SkyHao723/new_gimbal/交接说明.md

# 交接说明 —— 云台电机闭环 FOC 调试（STM32 测试版 → G431 正式版）

> 2026-10-16 G431：已按用户新原理图建立 [G431 Keil5 工程](keil5_g431/README.md)，
> 使用 CAN + AS5600；初步上电诊断已运行，修复 PB8/BOOT0 启动选择。
> SWD 已恢复，最终 CAN 单帧版已下载并校验；170MHz 主循环正常、异常寄存器为0、保持失能。
> 当前 nFAULT=0、编码器未应答。USB-CAN 实际为 candleLight（1D50:606F），走 gs_usb 通道0，
> 不是 COM8；500kbit/s 查询尚无回复。等待接口电压测量，尚未做 G431 旋转测试。
> 用户实测 24V 正常，但 SDA/SCL 约 0.1V，DRV 的 5V 只有约 1.7V，CAN VCC 也取自该 5V。
> 优先检查 Buck 输出电容 CBK（22uF/10V + 22~47uF 储能）、47uH 电感、FB_BK 输出节点及
> VSEL_BK 悬空状态；5V 恢复前不接 CAN 负载、不使能电机。AS5600 若无板载上拉，PB6/PB7
> 还需各加约 4.7kΩ 到 3.3V。

> 2026-10-16：已建立独立的纯 C / SPL / Keil5 工程
> [keil5_foc/gimbal_foc.uvprojx](keil5_foc/gimbal_foc.uvprojx)，保留 PlatformIO 最新参数和功能。
> Keil 全量构建 0 错误/0 警告、离线测试通过。静音稳定基线已提交为 `f888ddb`；
> π 附近到位摆动改善版已提交并推送为 `8b74ca8`；之后的提速候选已烧录、完成短时实测。
> 后续已优化末段收敛并烧录，当前参数、实测和回退见 [到位收敛优化](docs/到位收敛优化-2026-10-16.md)。
> 详细入口：[Keil 工程使用说明](keil5_foc/README.md)。原有目录与以下历史记录保留供参考。

> 用途：把当前工作交给另一个 AI 继续调试
> 生成日期：2026-10-15
> 工作目录：`D:\download\M创动工坊分享资料2.94-未发布`

---

# 一、给接手 AI 的提示词（可直接复制使用）

> ⚠️ **注意**：本文件是"调试过程中的完整记录"。其中第七节列的问题
> 已在 2026-10-15 轮次中修复并实测验证，
> **最新状态请看 `docs/调试成果-2026-10-15.md`**。

```
你接手一个嵌入式电机控制项目，需要继续调试。请先完整读完本文件，再动手。

【项目目标】
最终在 STM32G431 自制板 + DRV8316C 上实现云台电机闭环 FOC。
当前阶段：先用 STM32F103C8T6（蓝板）+ 厂家 SimpleFOC Mini 驱动板做验证，
跑通后再把代码移植到 G431。

【当前进度】
- 已跑通：时钟/I2C编码器/PWM驱动/FOC对齐/闭环位置控制
- 已修复并验证：串口丢包、对齐失败（见 docs/调试成果-2026-10-15.md）
- 待解决：闭环大幅移动时速度环失稳（见该文档第三节）
- 迁移 G431：见"第八节"

【工作方式要求】
1. 这个电机已经因误操作过热过 4 次，安全是第一优先级。
   动手前必读"第六节 安全须知"，里面每条都是踩坑换来的。
2. 主工程在 New_gimbal/foc_official/（PlatformIO + 官方 SimpleFOC 库）。
   构建：cd New_gimbal/foc_official && python -m platformio run -t upload
3. 不要随意改动 platformio.ini 里的 build_flags，那里有几处关键修复
   （串口命名坑、库兼容补丁），注释里已写明原因。
4. New_gimbal/app/ 下是早期用 SPL 手写的固件，已被官方方案取代，
   但其中的诊断思路（外设逐个初始化、串口诊断）仍可复用。
5. 硬件细节、引脚、实测参数都在本文档里，不要凭猜测改接线。
```

---

# 二、硬件清单

| 部件 | 型号/参数 | 备注 |
|---|---|---|
| MCU（当前） | **STM32F103C8T6** 蓝板 | 64KB Flash / 20KB RAM / 8MHz 晶振 |
| MCU（最终目标） | **STM32G431CBT6** LQFP48 | 自制板，尚未开始 |
| 驱动 | 厂家 **SimpleFOC Mini** | 板上芯片是 **DRV8316C**（TI） |
| 电机 | 外转子云台无刷电机 | Ø45×25mm，中空轴 7.5mm |
| 编码器 | **AS5600** 磁编码器 | I2C 地址 0x36，12 位 |
| 磁铁 | 预装径向磁环 Ø10×Ø5.5×2.5mm | **固定在电机轴上，随轴转动** |
| 电源 | 24V，**无电流限制功能，回路无保险丝** | ⚠️ 这是最大安全隐患 |

## 电机关键参数（厂家标称 + 实测）

| 参数 | 值 | 来源 |
|---|---|---|
| 相电阻 | **3.8 Ω**（两相之间） | 实测，两台独立电机一致 |
| 相电感 | 1.3 mH | 厂家 |
| 极对数 | **11** | SimpleFOC 对齐实测估算约 11.28；原厂家资料写 7，按实测闭环结果修正 |
| 额定电压 / 电流 | 24 V / **1.4 A** | 厂家 |
| 堵转电流 | 4.9 A | 厂家 |
| 额定功率 / 扭矩 | 33 W / 0.32 N·m | 厂家 |
| 最大扭矩 | 0.68 N·m | 厂家 |
| 扭矩常数 | 0.23 N·m/A | 厂家 |
| 空载电流 | 0.1 A | 厂家 |
| KV | 54 RPM/V | 厂家 |
| 工作电压范围 | 12–36 V | 厂家 |

**由 3.8Ω 推导的安全电压**（`I = V/3.8`，额定 1.4A → 理论上限 5.3V）：

| 电压 | 电流 | 判定 |
|---|---|---|
| 1.5 V | 0.39 A | 力矩不足，**实测电机不动** |
| **3.0 V** | **0.79 A** | ✅ **实测正常转动** |
| 5.3 V | 1.4 A | 正好额定 |
| 8 V | 2.1 A | ❌ 超额 |

---

# 三、工作目录结构说明

## 3.1 当前主工程（要用的）

```
New_gimbal/
├── foc_official/                    ★★★ 当前主工程（PlatformIO）
│   ├── platformio.ini               工程配置（含关键 build_flags，见注释）
│   ├── patch_simplefoc.py           编译前自动修补 SimpleFOC 与 core 的兼容问题
│   ├── include/MyUart.h             早期手写的寄存器直驱串口（现已被 Serial2 取代）
│   └── src/main.cpp                 ★ 主程序（官方 SimpleFOC 闭环）
├── tools/web_controller/            ★ 浏览器控制器（Web Serial，单文件）
│   ├── index.html
│   └── README.md
└── docs/                            调试文档（见 3.3）
```

## 3.2 早期手写固件（已被取代，可参考思路）

```
New_gimbal/
├── app/                             用 SPL 手写的固件（不依赖 Arduino 框架）
│   ├── mini_test.c                  最早跑通的固件：六步换相 + 电流采样 + 过流保护
│   ├── encoder.c / encoder.h        ★ 健壮版 AS5600 驱动（4 万次读零失败）
│   ├── encoder_test.c               编码器独立测试（磁铁状态/抖动/压力测试）
│   ├── encoder_fast.c               编码器加速版（一次 2 字节读）
│   ├── foc_cl.c                     三相正弦 FOC 闭环（起步死点问题）
│   ├── foc_sixstep_cl.c             六步换相闭环
│   ├── spin2.c                      带保护的旋转测试
│   ├── safe_test.c                  ★ 七层保护架构（安全设计参考）
│   ├── cal_curr.c                   电流采样外部标定
│   ├── peri_test.c                  ★ 外设逐个初始化诊断（定位卡死很好用）
│   ├── uart_dbg.c                   串口收发诊断
│   ├── enc_probe.c                  最小编码器探测
│   ├── Hardware/timer.c             TIM1 三路 PWM 初始化
│   ├── Hardware/delay.c             SysTick 延时
│   ├── SimpleFOC/                   厂家 2019 年移植版库（有 bug，见第五节）
│   ├── MyProject.h                  厂家移植版的头文件
│   └── stm32f10x_conf.h             SPL 配置头
├── build/                           GCC 构建脚本（PowerShell）
│   ├── build_*.ps1                  各固件的构建脚本
│   ├── startup_gcc.s                GCC 启动文件
│   ├── stm32f103c8.ld               链接脚本
│   ├── syscalls.c                   newlib 桩（让 printf 可用）
│   ├── clock.c                      RCC 时钟配置（72MHz）
│   └── diag_common.c                （旧版，已被 clock.c 取代）
├── reference/SimpleFOC_port/        厂家原始 Keil 工程副本（未修改，供对照）
└── library/                         STM32F10x 标准外设库 SPL v3.5.0
```

## 3.3 文档

```
New_gimbal/docs/
├── 官方SimpleFOC方案.md        ★ 当前方案的完整说明（为什么用官方库、两个兼容问题）
├── 官方参考代码索引.md          ★ 官方参考代码位置 + 黄金参数 + SVPWM 等价性推导
├── 安全架构.md                 ★ 七层保护设计（必读）
├── 电流标定结论与更正.md         ★ 电流采样标定的曲折过程与最终结论
├── 闭环调试记录.md              阶段 3 调试记录（7 个重要踩坑经验）
├── 闭环FOC实施规划.md           最初的 6 阶段规划
├── 调试总结与安全指南.md         早期总结
└── 接线检查表.md                接线核对表
```

## 3.4 工作区其他目录（厂家原始资料，只读参考）

| 目录 | 内容 | 是否有用 |
|---|---|---|
| `常用测试源码-配合说明书使用/` | 厂家提供的 3118 个文件 | ★★★ **内含官方 SimpleFOC 完整库** |
| `code/` | Keil 工程（`4_closeloop_M1` 等） | 厂家 2019 移植版，有 bug |
| `说明书/` | 接线图、测试说明 PDF | 查接线用 |
| `代码开源/` | 各种 rar/zip 参考工程 | 其中 `STM32F405_SFOCminiV2-带电流采样.zip` 值得看 |
| `3D模型与尺寸图纸/` | 电机与驱动板 3D | 做结构时用 |
| `相关软件/`、`自制平衡小车-开源地址/`、`test/`（空） | 其他 | 无用 |

### ★★★ 官方库的确切位置（很重要）

```
常用测试源码-配合说明书使用\ESP32_SimpleFOC_BLE\ESP32_SimpleFOC_BLE\
  .pio\libdeps\lolin_d32\Simple FOC\
```

这里面有：
- 官方 SimpleFOC 2.4.0 **完整源码**
- **官方蓝板专用示例**（与我们硬件几乎一致）：
  ```
  examples\hardware_specific_examples\Bluepill_examples\
      magnetic_sensor\bluepill_position_control\     <- AS5600 闭环
      encoder\bluepill_position_control\             <- ABZ 编码器
  examples\hardware_specific_examples\SimpleFOCMini\angle_control\
  ```
- 官方 STM32 驱动：`src\drivers\hardware_specific\stm32\`
- 官方 F1 电流采样：`src\current_sense\hardware_specific\stm32\stm32f1\`
- 内置 AS5600 驱动：`src\sensors\MagneticSensorI2C.cpp` 里的 `AS5600_I2C` 配置

---

# 四、引脚接线（当前 STM32 测试版）

| 功能 | STM32F103 引脚 | 接到 |
|---|---|---|
| PWM1 / PWM2 / PWM3 | **PA8 / PA9 / PA10** | 驱动板 IN1 / IN2 / IN3 |
| EN（使能） | **PB0** | 驱动板 EN（高电平使能） |
| 串口 TX / RX | **PA2 / PA3** | USB-TTL 的 RXD / TXD（**交叉**） |
| 编码器 SCL / SDA | **PB6 / PB7** | AS5600（I2C1） |
| SWD | PA13 / PA14 | ST-Link |
| LED | PC13 | 板载（心跳） |
| GND | GND | **所有设备必须共地** |

**供电**：驱动板进 **24V**；蓝板用 USB 或 5V 脚（**绝不能进 24V**）。

---

# 五、已知的关键坑（都是实测踩出来的）

## 5.1 串口命名坑（导致命令丢一半）

Arduino STM32 core 的定义与直觉不同：

```c
// cores/arduino/Serial.cpp
Uart Serial1(USART1);   // ← Serial1 其实是 USART1 (PA9/PA10)
Uart Serial2(USART2);   // ← Serial2 才是 USART2 (PA2/PA3)
```

- PA9/PA10 已被 PWM 占用，**用 `Serial1` 等于去抢 PWM 引脚** → 收发不可靠
- 正确做法：用 **`Serial2`**，并在 `platformio.ini` 里定义：
  ```
  -D HAVE_HWSERIAL2
  -D PIN_SERIAL2_TX=PA2
  -D PIN_SERIAL2_RX=PA3
  ```
- **不要**定义 `HAVE_HWSERIAL1`，否则 Serial1 会和 PWM 抢引脚

## 5.2 SimpleFOC 2.4.0 与新版 Arduino core 不兼容

```
stm32_mcu.cpp:126: error: cannot convert 'TIM_HandleTypeDef*' to 'TIM_TypeDef*'
    enableTimerClock(handle);
```

**根因**：SimpleFOC 自己的 `enableTimerClock(TIM_HandleTypeDef*)` 被包在
`#if defined(__MBED__)` 里，STM32Duino 下不编译 → 链接到了 Arduino core
的同名函数（签名是 `TIM_TypeDef*`）。

**修复**：`enableTimerClock(handle)` → `enableTimerClock(handle->Instance)`，
已用 `extra_scripts = pre:patch_simplefoc.py` 自动打补丁（重装库也不丢）。

## 5.3 电压太低电机不动

- `voltage_limit = 1.5V` 时**电机完全不动**（力矩不足以克服静摩擦/齿槽力）
- 现象：使能后有保持力、有嗡嗡声、电流约 0.2A，但角度完全不变
- `voltage_limit = 3.0V` 时**正常转动并稳定**
- 3V 下仍有约 0.13 rad 静差（位置环是纯 P 控制，无积分项）

## 5.4 速度读数不可信

转角静止时 `vel` 会乱跳（0.7~2.7 rad/s）。原因：角度只有 ±1 LSB 噪声，
差分测速把噪声放大。**判断电机是否在动要看 `angle`，不要看 `vel`。**

## 5.5 厂家的 SimpleFOC 移植版有 bug（`New_gimbal/app/`）

- **`setPhaseVoltage()` 写 TIM2，但 PWM 在 TIM1** → FOC 算出的占空比
  全写进一个没接输出的定时器，表现为"电机永远不转"
- `SystemInit()` 不配 PLL，实际跑 HSI 8MHz（PWM 变成 2.8kHz）
- I2C 超时后不发 STOP，总线永久卡死

**这就是改用官方库的原因。**

## 5.6 ADC 采样与 PWM 不同步（早期手写固件的问题）

PWM 开着时电流读数在 0.005A 和 0.3A 之间剧烈跳动。
原因：ADC 自由转换（~200kHz）与 25kHz PWM 不同步，平均值要么全落在
"导通期"要么全落在"关断期"。
**官方库的 STM32F1 电流采样实现已处理这个问题。**

## 5.7 其他坑

- **I2C 引脚电平测量前必须先 `PE=0` 关掉外设**，否则读到的是外设拽住的
  状态，会误判成"硬件短路"（我曾因此误判编码器损坏）
- **看门狗在调试阶段有害**：卡死时不断复位，连 ST-Link 都连不上，需断电恢复
- **编译器会把"读标志位"的循环优化成死循环**（`bpl` 跳回自己），
  必须用 `volatile` + 函数封装
- **PowerShell 5.1 中文脚本会乱码**导致语法错误，脚本建议纯 ASCII
- **中文路径会让部分工具误报"文件不存在"**，可建 ASCII 软链接绕过：
  `cmd /c mklink /J D:\dsh_build\xxx "中文路径"`

---

# 六、安全须知（★ 必读，电机已过热 4 次）

## 6.1 当前最大的安全隐患

**电源没有电流限制功能，回路也没有保险丝。** 这是唯一不依赖软件的保护层，
目前完全缺失。

**强烈建议补一个（任选其一）**：
| 方案 | 成本 | 效果 |
|---|---|---|
| 限流电源 | 可能已有 | 首选，电流一到自动降压 |
| **2A 快断保险丝** | 几毛钱 | 未来任何固件出错都能救电机 |
| 10Ω/10W 电阻串联 | 手头可能有 | 临时替代，电流物理限制在 2.4A |

## 6.2 绝对禁止

- ❌ **直流锁死测试**（某两相加固定直流、第三相悬空）—— 无旋转无反电动势、
  无斩波限流，电流完全由 V/R 决定，最容易烧电机
- ❌ 无人监控的长时间通电
- ❌ 电压超过 5V（3.8Ω 下会超过额定 1.4A）
- ❌ 上电前不摸电机温度

## 6.3 每次测试必须

1. 电机固定好，周围无人
2. 手放在电源开关上
3. **用电流表实时监控**（不要只信固件读数）
4. 上电前摸电机温度，热的绝不上电
5. 单次通电时间尽量短

## 6.4 过热事故复盘（为什么电机没坏）

`B2` 直流测试时固件显示 1.62A，但真实电流只有约 0.53A —— 多出的来自
**电流零点漂移**（实测漂 94 counts）。电机实际只承受了额定的 38%，
所以没有匝间短路（两台电机电阻 3.8Ω / 4.4Ω，正常）。

**教训**：标定电流要用**独立可靠的仪表**（电流表串在回路里），
不要用总电源功率计间接推算。

---

# 七、未解决的问题（接手 AI 从这里开始）

> **更新（2026-10-15）**：7.1 和 7.2 已修复并实测验证，
> 详情见 `docs/调试成果-2026-10-15.md`。以下保留记录，供理解来龙去脉。

## 7.1 串口命令可靠性 ✅ 已修复并验证

**现象**：命令大约每两条丢一条。

**根因**：`Serial1` 实际是 USART1（PA9/PA10，已被 PWM 占用），
应该用 `Serial2` 才是 USART2（PA2/PA3）。

**修复**：
- `platformio.ini` 加 `-D HAVE_HWSERIAL2 -D PIN_SERIAL2_TX=PA2 -D PIN_SERIAL2_RX=PA3`
- `main.cpp` 改用核心的 `Serial2`（删掉手写的 `MyUart.h`）

**实测结果**：`20x R → 20/20`，`20x ? → 20/20`，突发 10 条 `→ 10/10`，
参数命令确实生效。**100% 可靠。**

## 7.2 对齐失败导致电机完全不动 ✅ 已修复并验证

**现象**：`dir=UNKNOWN`、`zero_electric_angle=-12345`(NOT_SET)、电机完全不动。

**根因**：对齐电压只有 **1.0V**，推不动转子。
SimpleFOC 的 `alignSensor()` 需要让转子**转一整圈**来测传感器方向
（正转 500 步 + 反转 500 步，比较 `mid_angle`/`end_angle`），
1.0V 正是实测"完全不动"的电压 → 方向检测失败 → FOC 不知道电角度零点
→ 输出电压相位错误 → 电机不动。

**修复**：`ALIGN_VOLTAGE` 从 `1.0f` 提到 `3.0f`。

**实测结果**：`dir=CW`，`zero_electric_angle=2.8256`。

**原则**：**对齐电压必须 >= 能可靠推动转子的电压。**

## 7.3 闭环大幅移动时速度环失稳 ⚠️ 待解决（当前主要问题）

**能工作**：
```
小步移动 0.2 rad:  moved=0.2009  err=-0.0009   (误差 0.09%)
                   moved=0.2010  err=-0.0010
                   moved=0.2101  err=-0.0101
静止保持 3s:       drift = 0.0000 rad          (完全无漂移)
```

**不工作**：累积移动超过约 **0.6 rad** 后失稳
```
step 4: moved=0.9388  err=-0.7388    (期望 0.2)
step 5: moved=-0.7547 err=0.9547
```

**根因**：速度环被编码器噪声污染。AS5600 是 12 位，`vel` 由角度差分得到，
角度仅 ±1 LSB 噪声就被放大成 **2.7 rad/s 的假速度**（实测：静止时
`angle` 完全相同 `4.844`，而 `vel` 在 0.69/0.96/2.73 之间乱跳）。

**建议方向**（每次只改一个参数，用 `test/closedloop.ps1` 复测）：

| 参数 | 当前值 | 建议 |
|---|---|---|
| `LPF_velocity.Tf` | 0.01 | 加大到 0.05~0.1（更强滤波） |
| `PID_velocity.P` | 0.2 | 降到 0.05~0.1 |
| `PID_velocity.I` | 20 | 降到 5~10 |
| `P_angle.P` | 20 | 降到 8~12 |
| `V_LIMIT` | 3.0V | 试 4.0V |

**另一条路**：启用电流采样（CS1/CS2/CS3 → PA0/PA1/PB1），
改用 `TorqueControlType::foc_current`，绕开速度环噪声问题。

## 7.4 电压上限待调优

当前 3.0V 能转但可能不是最优。建议在电流表监控下逐步试 3.0 → 4.0 → 5.0V，
找到既可靠跟踪又不超过额定电流的值。

## 7.5 电流采样未使用

官方库的 STM32F1 电流采样（`stm32f1_mcu.cpp`）没有启用。
驱动板有 CS1/CS2/CS3 输出（接 PA0/PA1/PB1），启用后可做电流环与可靠过流保护。

## 7.6 Web 控制器待联调

`New_gimbal/tools/web_controller/index.html` 已适配固件命令集
（E/D/T/V/L/R/?），解析逻辑已单测通过，串口问题已修复，可实测了。

---

# 八、迁移到 G431 的方案（最终目标）

| 项目 | STM32F103（当前测试版） | STM32G431（最终正式版） |
|---|---|---|
| 时钟 | HSE 8MHz → PLL → 72MHz | HSE 8MHz → PLL → **170MHz** |
| PWM | TIM1 CH1/2/3 → PA8/PA9/PA10 | TIM1 CH1/2/3，**改引脚** |
| 编码器 | I2C1 PB6/PB7（AS5600） | I2C1 或 SPI（建议 MT6701，抗干扰更好） |
| 电流采样 | 未启用 | **ADC1 注入组 + TIM1 触发**（官方库有 G4 支持） |
| 驱动 | 厂家 SimpleFOC Mini | **自制 DRV8316C 板** |
| 库 | 官方 SimpleFOC 2.4.0 | 同一个库，官方有 G4 硬件支持 |

**官方库对 G431 的支持**（已在工作区里）：
```
src\current_sense\hardware_specific\stm32\b_g431\b_g431_hal.cpp
examples\hardware_specific_examples\B_G431B_ESC1\B_G431B_ESC1.ino
```

**移植要点**：
1. PlatformIO 里把 `board = bluepill_f103c8` 换成 G431 对应板子
2. 引脚宏改成 G431 的（`PA8` 等命名通用，但引脚号不同）
3. 串口改用 G431 的（注意 G431 是 `Serial1`=USART1 等，具体看 variant）
4. 时钟配置由 Arduino core 自动处理，一般不用管
5. 电机参数（极对数 11、3.8Ω、额定 1.4A）保持不变；极对数以 SimpleFOC 对齐实测为准
6. **自定义 DRV8316C 板的外围电路设计**见工作区根目录的：
   - `DRV8316C_外围电路设计总结.md`
   - `DRV8316C_三路PWM_电源方案分析.md`
   - `G431_最小系统检查清单.md`

---

# 九、当前状态速查

## 已验证 ✅

| 项目 | 证据 |
|---|---|
| 时钟 72MHz | `SysClk=72000000` |
| I2C 编码器 | AS5600 读数为 `angle=5.0545`；早期版本 4 万次读零失败 |
| PWM + 驱动 | 使能后有明显保持力、嗡嗡声、电流约 0.2A |
| FOC 对齐 | `dir=CW`，`zero_electric_angle=2.8256` |
| **串口可靠性** | **20x R → 20/20，20x ? → 20/20，突发 10 条 → 10/10** |
| **闭环小步移动** | **0.2 rad 步进误差 0.09%~0.5%** |
| **闭环静止保持** | **3 秒漂移 0.0000 rad** |

## 待解决 ⚠️

| 项目 | 状态 |
|---|---|
| 闭环大幅移动失稳 | 累积 > 0.6 rad 后速度环失稳（见 7.3） |
| 电压上限调优 | 3V 能用，未找最优 |
| 电流采样/电流环 | 未启用 |
| Web 控制器联调 | 代码就绪，串口已修好，可实测 |
| G431 移植 | 未开始 |

## 当前固件

`foc_official/src/main.cpp` 是**正式版固件**（串口交互控制，已实测可用）。

启动日志（实测）：
```
SimpleFOC 2.4.0 / STM32F103 + DRV8316C + AS5600
SysClk=72000000
UART: Serial2 = USART2 (PA2/PA3)
[1] sensor AS5600 @0x36  angle=5.6282
[2] driver OK
[3] Vlim=3.00V (~0.79A)  Vellim=20.0
[4] motor.init OK
aligning (initFOC)...
aligned: dir=CW
         zero_electric_angle=2.8256
motor DISABLED - send E to enable
commands: E D T<n> V<n> L<n> R ?
```

闭环实测（`test/closedloop.ps1`）：
```
小步 0.2 rad:  moved=0.2009  err=-0.0009
               moved=0.2010  err=-0.0010
               moved=0.2101  err=-0.0101
静止 3s:       drift = 0.0000 rad
累积 >0.6 rad: 失稳（见 7.3）
```

> ⚠️ **注意**：早期版本曾在 `foc_official/src/main.cpp` 放过"自包含测试固件"
> （参数写死、自动跑一次移动测试）。该版本在 `initFOC()` 后
> **没有调用 `motor.disable()`**，会导致电机持续高频抖动。
> 现在的正式版已有 `motor.disable()`，**不要再退回那个版本**。

---

# 十、常用命令速查

## 构建与烧录

```powershell
cd D:\download\M创动工坊分享资料2.94-未发布\New_gimbal\foc_official
python -m platformio run              # 编译
python -m platformio run -t upload    # 烧录（ST-Link）
```

首次编译会自动下载 STM32 平台 + Arduino 框架 + SimpleFOC 库（约 5 分钟）。

## 固件串口命令（115200 8N1）

| 命令 | 作用 |
|---|---|
| `E` | 使能 |
| `D` | 失能 / 急停 |
| `T<n>` | 目标角度 (rad)，如 `T0.5` |
| `V<n>` | 电压上限 (V)，如 `V3` |
| `L<n>` | 速度上限 (rad/s) |
| `R` | 读编码器 |
| `?` | 状态 |

## 用 ST-Link 复位（固件卡死时）

```powershell
& 'D:\program\STM32CubeCLT_1.21.0\STM32CubeProgrammer\bin\STM32_Programmer_CLI.exe' `
  -c port=SWD mode=hotplug -rst
```

## 隐藏工具

- 工作区里有 `_serial_openloop.ps1`、`_serial_test.ps1`（早期串口测试脚本）
- `D:\dsh_build\` 下有一些调试脚本（软链接与测试脚本，非项目文件）

---

# 十一、一句话总结现状

**硬件与固件主链路已全部打通，且主要问题已修复验证：**
时钟、编码器、PWM、驱动、FOC 对齐、闭环小步定位、串口通信全部正常。

| 状态 | 项目 |
|---|---|
| ✅ | 串口丢包（`Serial1`/`Serial2` 命名坑）—— 已修复，100% 可靠 |
| ✅ | 对齐失败（对齐电压 1.0V 推不动）—— 已修复，`dir=CW` |
| ✅ | 闭环小步移动（0.2 rad 误差 0.09%）+ 静止无漂移 |
| ⚠️ | **闭环大幅移动失稳**（累积 > 0.6 rad）—— 当前主要待解决项 |
| ⚠️ | 速度环参数调优、电流环启用、G431 移植 |

**下一步优先级**：调速度环参数（见 7.3）→ 启用电流采样 → G431 移植。

详细成果见 `docs/调试成果-2026-10-15.md`。
