SkyHao723/new_gimbal/docs/g431-抖动-位置环极限环.md

# 抖动根因之二：位置环增益过高引起 ~57 Hz 极限环（2026-10-28）

## 结论

**"转到位后静止保持时剧烈高频抖动"不是编码器、不是机械、不是某块板的硬件问题，而是
`MOTOR_ANGLE_P = 40` 在 398 Hz 控制频率下裕度不足引出的极限环。把位置环增益降到 25 后，
三块板都能复现的抖动彻底消失，位置精度与匀速抖动基本不变。**

- 同一套固件/参数下，三块板都会在"走一段 → 停住"之后振荡（`angle_std` 29~48 mrad、
  峰峰 90~113 mrad），只是 2 号电机最容易激发，所以之前看起来像"只有 2 号有问题"。
- 抖动只在**保持阶段**出现，转动过程正常；这与"编码器坏了"的表现（转动中也乱跳）不同。
- 已被排除：AS5600 低功耗（CONF=0，`updates/s` 400+）、编码器静态噪声（失能时 3 秒内
  `angle` 跨度 0.0015 rad）、电流读数（uq 与实测母线电流已对齐）、三相/功率级（DC 锁相
  六步 ±0.08 A 对称）。

## 量化证据

复现序列（`D:\dsh_build\osc_probe.py`，经 CAN）：

```
D → V2.5 → E → T(目标-2rad) → 等 2.5s → T(目标) → 1.2s 后采样 R 1.5s
```

| 板 | `MOTOR_ANGLE_P` | hold -1.0 rad | hold +2.0 rad | hold +π |
|----|---|---|---|---|
| node1 | 40 | 35.0 mrad | 37.7 mrad | 35.7 mrad |
| node2 | **25** | **2.01 mrad** | **1.14 mrad** | **0.97 mrad** |
| node3 | 40 | 38.8 mrad | 35.7 mrad | 39.9 mrad |

（表中为 `angle_std`；node2 单独改成 25 后同序列完全安静，2.5V 与 8V 上限都是 1~2 mrad。）

板载黑匣子抓到的原始波形（`X` 命令，1200 拍 @398 Hz）：

```
angle 在 -1.058 ~ -0.948 rad 之间摆动（峰峰 110 mrad ≈ 72 counts）
每 4~6 拍一个来回 → 观测周期 17.6 ms（≈57 Hz，接近采样率的 1/7）
uq 有 32% 的采样顶在 ±2.5 V（vlim 饱和）→ 典型极限环
把 vlim 降到 1.2 V（uq 无法饱和）→ 抖动消失（pp 4.6 mrad）
```

## 为什么是增益问题

- 位置环是"位置误差 → 速度指令"的 P 环：`velocity_sp = Ap·(target-angle)`，
  Ap=40 相当于 40 rad/s 的刚度，而控制频率只有 398 Hz（软件 I2C 读 AS5600 占掉 2.25 ms/拍）。
- 速度反馈经过 `Tf = 0.02 s` 一阶低通，在 57 Hz 处相位滞后很大、幅值被压到 ~10%，
  等于**高频段几乎没有阻尼**；再加上位置环 40 的高增益和一拍采样延迟，闭环在 50~60 Hz
  附近相角越过 180°，于是自激。
- 电机静摩擦/齿槽越大越容易激发 → 2 号电机最先暴露。
- 增益降到 25 后裕度重新变正；实测 1 rad / 2 rad 阶跃稳态误差 0.006~0.017°（与 40 时的
  0.0002~0.002 rad 同量级），1.5 / 9 rad/s 匀速抖动 7.8 / 11.2 mrad（比 40 时略好）。

## 想更硬的位置环怎么办

不要直接加 `MOTOR_ANGLE_P`。先把控制频率提上去：

1. `New_gimbal/keil5_g431/BSP/as5600.c` 的 `ENCODER_I2C_HALF_US`（当前 25 µs ≈ 20 kHz SCL）
   降到 5 µs 可把循环提到 ~1.9 kHz（2026-10-27 实测 `sensor_errors` 仍为 0）；
2. 循环快了以后再逐步加 Ap，同时观察本文件里的复现序列。

## 复现与排查步骤

1. 固件保持 `G431_*_TEST` 全 0（交付态），板子跑正常闭环固件。
2. 用 `D:\dsh_build\osc_probe.py <vlim> <hold...>` 直接对比三块板；
   输出 `angle_std > 20 mrad` 即说明还在振荡。
3. 需要原始波形时：`{"node":N,"cmd":"X"}`（网页上的「抓抖动波形 (X)」按钮等价），
   3 秒后 `nm` 取 `bench_trace` / `bench_trace_meta` 地址，
   `STM32_Programmer_CLI -r32 <addr> <bytes>` dump，再用 `D:\dsh_build\trace_osc.py` 统计。

## 改动清单（本次）

- `New_gimbal/keil5_g431/User/motor_config.h`：`MOTOR_ANGLE_P 40.0f → 25.0f`。
- 黑匣子（此前未入库，随本次一起提交）：`can_commands.c` 白名单加 `X`、
  `main.c` 的 `trace_armed` 记录与 `X` 命令、`bench_current.c/h` 的 `bench_trace[1200*3]`
  与 `bench_trace_run()`、`tools/g431_can_bridge.py` 的 `SINGLE_BYTE += "X"`、
  `tools/web_controller/index.html` 的「抓抖动波形 (X)」按钮。

## 三块板复测（2026-10-28，全部烧入 `MOTOR_ANGLE_P=25`）

同一复现序列，`angle_std`：

| 板 | hold -1.0 | hold +2.0 | hold +π | 阶跃误差 |
|----|---|---|---|---|
| node1 | 0.73 mrad | 1.03 mrad | 6.65 mrad | 0.006~0.109° |
| node2 | 1.87 mrad | 0.95 mrad | 1.16 mrad | 0.006~0.017° |
| node3 | 2.84 mrad | 1.03 mrad | 1.34 mrad | 0.011~0.080° |

改前 node1 / node3 同序列分别是 35~38 mrad 与 36~40 mrad。三块板同总线同时动作的互扰复测
（`multi_test.py`）最大误差 0.0001 rad，只命令 node2 时 node1/node3 漂移 0.00000 rad。

## 未完成

- 本极限环是"采样率 + 增益"问题。若后续把循环提到 1.9 kHz（软件 I2C 半周期 25 µs → 5 µs），
  需要重新扫一遍 `MOTOR_ANGLE_P` / `MOTOR_VELOCITY_*` 的最优值，可以试更高的位置刚度。
- node1 在 +π 处仍有 6.65 mrad（远小于振荡时的 35 mrad，可接受）；若要求更高可再单独看该角度。
