SkyHao723/new_gimbal/docs/motor-limits-2026-10-27.md

# 电机参数与固件限幅（2026-10-27）

依据用户提供的电机参数表：额定电压 24V、额定电流 1.4A、堵转电流 4.9A、额定转速 1000rpm、额定功率 33W、相电阻 5.4Ω、绕组电阻 3.6Ω、扭矩常数 0.23Nm/A。电阻字段彼此不一致，因此只作范围估算，不当作实测电流。

## 本次调整

仅 G431 源码的默认电压指令上限从 3V 调到 4V；软件绝对上限保留 5V。F103 配置和用户已有控制器改动保持不变。按电阻字段估算，4V 静态电流约为 0.74A（按 5.4Ω）至 1.11A（按 3.6Ω），约为额定电流的 53%～79%；对应扭矩粗估约 0.17～0.26Nm。实际相电流受电机接法、SVPWM 电压定义、PWM 纹波、运动反电势和绕组温升影响，必须用实测确认。

没有提高 5V 绝对上限、加速度或启动动作。软件速度参数 MOTOR_VELOCITY_LIMIT=20rad/s 约 191rpm，但轨迹 MOTOR_TARGET_SLEW=6rad/s（约 57rpm）才是当前实际命令速度上限；相对电机 1000rpm 额定速度，这已经很低。单独抬高速度上限不会解除 6rad/s 轨迹限制。

## 保护能力边界

现有 FOC 软件是电压模式：没有在控制算法中实现运行时相电流闭环/限幅，也没有电机绕组温度传感器。因此 4V 是温和的电压起点，不是“保证不会烧”的热保护。额定电流通常按厂家冷却和工作条件给定；长时间堵转或静态大力保持仍需测温、监控实际相电流并限制连续负载。

## 当前版 G431 原理图复核（2026-10-27）

用户提供的 2026-10-20 当前版原理图已归档到 [`hardware/g431-current-2026-10-20`](hardware/g431-current-2026-10-20/)。按图中硬件引脚配置型 DRV8316：MODE 通过 47kΩ 接 VDD/AVDD，INLA/B/C 接 VDD，选择 3x PWM；VREF/ILIM 接 VDD/AVDD；GAIN 接 PGND，SOA/SOB/SOC 分别接 PA0/PA1/PA2。按 TI DRV8316 数据手册，GAIN 接地对应 0.15V/A 电流检测增益，三路模拟电流检测输出可供 MCU 使用。

因此新板具备实现软件电流监测/限流的硬件信号路径，但当前 G431 FOC 工程没有 ADC 初始化或采样代码，仍是电压模式。SOx 检测的是各相低侧 FET 电流，固件需按 PWM 时序采样并先校准零电流偏置，不能把三个任意时刻的 ADC 电压直接当作绕组电流。

OCP/SR 接 PGND。TI 数据手册对 OCP 引脚接 AGND 的硬件配置给出典型 16A（最小 10A、最大 21.5A）过流阈值；该阈值高于电机 4.9A 堵转电流，不能作为电机绕组保护。DRV 内部过温关断保护的是驱动芯片本身，也不保证绕组安全。数据手册：[DRV8316](https://www.ti.com/lit/ds/symlink/drv8316.pdf)。

当前版图中 DRVOFF 固定接 PGND，MCU PB1 标注未连接；实际硬件停机应使用 PB0/nSLEEP 拉低并清 TIM1.MOE。普通 FOC 工程的 `board_driver_set(0)` 目前清 MOE 并操作未连接的 PB1，但没有拉低 PB0/nSLEEP，因此适配停机路径并复核之后才可刷入当前板。当前板仍运行独立诊断固件，G431 FOC 的 4V 参数仅在源码中，尚未刷入。

在添加、校准并验证同步电流采样及软件过流停机前，保持 4V 默认电压和 5V 软件绝对上限，不把 OCP 或电压指令当成电机热保护。
