SkyHao723/new_gimbal/docs/网页位置运动优化-2026-10-16.md

# 网页角度运动平滑性优化（2026-10-16）

> 本文记录第一轮候选及当时测试。之后用户反馈 π 附近仍有约 3° 摆动，
> 已复现并继续调整反馈增益/滤波；当前参数和烧录状态见 [到位振荡调参](到位振荡调参-2026-10-16.md)。

用户澄清：上电自检只有很轻微的顿挫，主要问题是网页发送角度后运动抖动。
静音、静止保持稳定的源码已经提交为 `f888ddb`。本次修改当时在其后单独保留，
之后与到位振荡调参一起经用户确认改善、授权提交和推送。

## 修改

Keil 工程的普通 `T<n>` 位置控制采用梯形速度规划：规划速度上限 4rad/s，且服从 L；
规划加速度上限 4rad/s²。原来的目标匀速斜坡在开始/到位时改变目标速度，新规划增加
加速和减速段。位置环叠加规划速度前馈，减少跟随移动目标所需的位置滞后。
这是针对起停和目标跟随的改进，不能据此认定其他速度下的全部抖动来源。

运动中收到新 T，保留规划位置/速度后重新计算制动和后续运动；目标位于制动距离内时，
规划允许先制动越过目标，再反向返回。L 降低时规划速度逐步降低，速度环的 L 硬限幅仍
立即生效。E 从当前位置重新开始；D 清空规划；重复 E 不重置已有运动。

上述约束针对参考轨迹，不代表实测机械速度/加速度必定满足这些界限。
梯形规划的位置和速度连续，加速度分段变化，未实现限制 jerk 的 S 曲线。
速度 PI、位置 P、速度滤波、PWM、固定校准和上电单圈流程沿用基线。
网页仍发送同样的 T 指令，本次无需更新网页。

实现入口：`../keil5_foc/Control/trajectory.c`、`../keil5_foc/Control/motor.c`；
参数入口：`../keil5_foc/User/motor_config.h`。

## 实机记录

使用 COM8 / 115200、3V 电压上限，每次使能约 2.3 秒：从当前位置向正方向走一个小步，
1.15 秒后返回起点，再等 1.15 秒。查询约 44 次/秒，每次均以 D 结束并确认 EN=OFF。
基线使用优化前板上原有固件；候选使用 ST-Link 下载并由 STM32CubeProgrammer 校验通过。
每次复位后立即 D 中止自动单圈，本轮未重新测试完整上电单圈。

| 版本 / 步长 | 正向采样超调 | 正向末段摆幅 | 返回末段摆幅 | 正向累计路径 |
|---|---:|---:|---:|---:|
| 原基线 / 0.2rad（11.46°） | 2.78° | 5.63° | 0.00° | 36.91° |
| 初版规划，8rad/s² / 0.2rad | 1.90° | 0.09° | 0.00° | 15.76° |
| 当前规划，4rad/s² / 0.2rad | 未采到越过目标 | 0.09° | 0.18° | 11.94° |
| 当前规划，4rad/s² / 0.5rad（28.65°） | 未采到越过目标 | 0.36° | 0.26° | 28.83° |

末段摆幅是每个动作 0.8～1.15 秒的实测角度最大值减最小值；可能包含尚在收敛的运动。
累计路径是相邻采样的角度变化绝对值之和，基线明显多走的路程说明存在反复摆动。
当前版本 0.2rad 正向末点误差约 -0.034°；0.5rad 正向/返回末点误差约 -0.080° / +0.178°。

这是各一次短时往返对比，起始机械位置随复位后的短暂自检移动而不同，未做同位置重复
统计；采样也可能遗漏更短的振动。AS5600 单个计数约 0.088°，接近计数级的摆幅不宜过度
解读。本轮未测声音，也未覆盖全部速度、角度和负载，最终手感与噪声仍需用户体验确认。

原始采样与当时的测试脚本存于 [measurements/2026-10-16-motion](measurements/2026-10-16-motion)。
脚本默认会使能并运行小步往返，`--flash` 可指定待下载的 HEX；依赖本机 COM8、pyserial
和上述 STM32CubeProgrammer 安装路径。

## 构建与回退

Keil ARMCC 5.06 全量构建：0 错误、0 警告。

```text
Code=14096 RO-data=556 RW-data=68 ZI-data=3892
Flash=14720 bytes; RAM=3960 bytes（含栈和堆）
HEX SHA256=8656014B5AC5640361360A45947002113FF4F35F62D08DD52F79A47132A96959
```

主机测试通过：147 组轨迹终点/速度/加速度用例、变步长跨段积分、运动中反向重规划、
降速、规划完成保持、静止 PI 回归、速度前馈接入、D/E 重置，以及既有 PWM/编码器/
PI/故障/上电单圈状态机测试。离线测试不替代实机反馈。

当前烧录文件已另存 `D:\dsh_build\releases\gimbal-smooth-20261016\gimbal_foc.hex`。
稳定基线仍为 `f888ddb`，其 HEX / AXF 保存在 `D:\dsh_build\releases\gimbal-f888ddb`，
基线 HEX 哈希复核不变，见 [稳定基线](稳定基线-2026-10-16.md)。
需要回退时可用 ST-Link 下载该目录的基线 HEX；源码可在独立检出 `f888ddb` 后构建，
无需丢弃当前未提交的优化。
