SkyHao723/new_gimbal/docs/稳定基线-2026-10-16.md

# Keil 固件稳定基线（2026-10-16）

用户实机反馈：当前固件已无可感知噪音，停在指定位置时不抖动；运动时仍有顿挫感。
本记录将该反馈与当前源码保存为基线。声音与静止表现来自用户观察，未做声级仪测量。

工程：`keil5_foc/gimbal_foc.uvprojx`，STM32F103C8T6，ARMCC 5.06，纯 C99 / SPL。
参数：11 极对、方向 +1、固定电角度零点 0.92rad、电压上限 3V、速度 PI 0.2/5、
速度低通 0.05s、位置 P=20、位置目标匀速斜坡 4rad/s；上电开环转一圈后失能。

构建结果：0 错误、0 警告。当前 HEX 的 SHA256：

```text
72344E5D26A3060A4DC210241FE11B0350F7ADE612BFAD654F18D3542D550827
```

源码、标准库、Keil 工程配置和测试纳入版本管理，Objects/Listings 等生成文件继续忽略。
后续运动平滑性修改须与该基线分开，保留可回退版本；静止 PI/零点参数不应无依据改动。
