SkyHao723/new_gimbal/docs/闭环FOC实施规划.md

# 闭环 FOC 实施规划

> 目标：在 **测试版**（STM32F103C8T6 + SimpleFOC Mini/DRV8316C + AS5600）上打通闭环
> 原则：**安全性优先**，每一步独立可验证，任何一步失败都能安全回退
> 基线：固件 `mini_test.c`（六步换相）已实测通过，作为**永远可回退的安全版本**

---

## 一、现状与阻塞点

### 已完成（有实测依据）

| 能力 | 验证方式 |
|---|---|
| PWM TIM1/PA8-9-10，25kHz 中心对齐 | 寄存器 `BDTR=0x8000`、`CCER=0x111`、`ARR=1439` + 万用表实测 |
| 六步换相旋转 | 空载电流 < 0.1 A（标称 0.1 A） |
| 电流采样 + 零点标定 | 漂移 ±0.005 A；1V→0.142A / 2V→0.317A，反推电阻 6.5Ω |
| 过流硬切断 | 自检通过（阈值降到 0.05A 未误触发） |
| 72MHz 时钟 | `SystemCoreClock=72000000` |

### 唯一阻塞点：编码器在控制循环中的可靠性

**现象**
- 调试固件里，`Motor_init()` 帧内读 `getAngle()` 正常
- 但在**控制主循环**中长期运行后，读数失败 → `I2C_getRawCount()` 返回 0 → `shaftAngle` 变 **NaN**
- 慢速调 `angle=nan` 反复出现

**根因分析（三个叠加因素）**

1. **I2C 驱动本身脆弱** — 原参考工程用「POS 位技巧 + 直接寄存器操作」，且所有超时路径 `return 0` **不发 STOP**，一次失败就把 SCL 拉死（已修，但未在闭环中验证）
2. **400kHz 在排线上太快** — 信号完整性差，读十次错两三次
3. **无数据有效性检查** — 脏数据（0 / NaN）直接被 FOC 拿去算换相角

**危害等级：高**
编码器脏数据 → 换相角错误 → 电机失步 → 等效堵转 → 大电流（与 145W 事故同一机制）

### 设计原则

> **编码器不可信，就绝不能开闭环。**
> 因为开环至少是"我知道它在转"，闭环脏数据是"它在乱转还可能烧电机"。

---

## 二、阶段划分

每个阶段都有：**目标 / 任务 / 验收标准 / 停止条件**
**未通过验收，不进入下一阶段。**

---

### 阶段 0 — 基线与安全网（0.5 天）

**目标**：确保任何时候都能安全回退到已验证的开环版本

**任务**
- [x] `mini_test.c` 已推送到仓库（可回退基线）
- [ ] 备份当前可工作固件 `mini.hex` 到 `firmware/` 目录
- [ ] 确认恢复流程：一条命令烧回开环版
- [ ] 建立测试记录表（电压 / 电流 / 现象）

**验收**
- 能从仓库产物烧回开环版并成功转起来

**产出的安全网**
```
任何时候出问题 → 烧 mini.hex → 回到已知可用状态
```

---

### 阶段 1 — 编码器可靠性攻坚（★ 最高优先级，1~2 天）

**目标**：AS5600 在**控制循环频率下**（≥ 1kHz 读取）长期稳定，错误率 < 0.1%

**为什么单独作为一个阶段**
这是唯一的阻塞点，且解决它需要独立的测试装置。不掺任何电机控制代码，
纯粹验证"读角度"这一件事。

**任务**

1. **重写 I2C 读角度驱动**（不复用原参考代码）
   - 速率降到 **100 kHz**
   - 标准两步读（不用 POS 位技巧，简单优先）
   - 每个超时点：发 STOP + 清 POS + 恢复 ACK
   - 加**总线恢复**：卡死时用 SCL 脉冲解救从机
   - 读失败时返回一个**明确无效标志**，而不是 0

2. **数据有效性校验**
   - 连续两次读，差值 < 阈值才接受
   - 与上一次比，跳变 > 某阈值 → 判为野值丢弃
   - 累计失败计数器（可读）

3. **独立测试装置**（新固件 `encoder_test.c`，不接电机）
   - `R` 连续读取 N 次，打印失败次数与角度抖动
   - 静态：读数应稳定（抖 < 2 LSB）
   - 手动转轴：角度应单调变化
   - **持续 10 分钟压力测试**

**验收标准**

| 指标 | 要求 |
|---|---|
| 静态角度抖动 | < 2 LSB (4096) |
| 手动连续转动 | 角度单调、无跳变 |
| 10000 次读取失败率 | **< 0.1%** |
| 失败后能否自愈 | 下一次读必须成功（不能卡死） |
| 10 分钟长跑 | 无累积性失败 |

**停止条件**（任一出现则暂停，换方案）

- 错误率 > 1% 且降速/加滤波无效
- 总线反复卡死，恢复机制不能自愈

**备选方案（按优先级）**

1. 降到 100 kHz + 缩短排线 + 检查上拉（**首选，最可能直接解决**）
2. 增加"读两次取一致"的双读冗余（软件容错）
3. 改用 AS5600 的 **PWM 输出**（单线，抗干扰远好于 I2C，引脚 PA0/PA1/PB1 已有）
4. 换成 SPI 编码器（MT6701，厂家也有资料）

> ⚠️ 注意：仓库 `reference/` 里有厂家给的其他方案（ESP32 + MT6701 等），
> 如果 AS5600 实在不稳，换编码器比死磕 I2C 更划算。

**产出**：`app/encoder.c/.h` —— 一个经过验证的、可信的角度读取模块

---

#### 阶段 1 实测结果（✅ 已通过）

**测试时间**：2026-10-15　**固件**：`app/encoder_test.c`（不输出 PWM，EN 保持失能）

| 测试项 | 结果 | 判定 |
|---|---|---|
| SCL/SDA 空闲电平 | 均为 HIGH | ✅ 上拉有效 |
| 静止抖动（1000 次） | 跨度 **1 LSB** | ✅ 要求 < 5 LSB |
| **400 kHz 抖动（500 次）** | 0 / 1000 失败 | ✅ 400kHz 也能用 |
| **100 kHz 抖动（1000 次）** | 0 / 2000 失败 | ✅ |
| **压力测试 20000 次** | **0 / 40000 失败，错误率 0.0000%** | ✅ **要求 < 0.1%** |
| abort（超时清理） | **0 次** | ✅ 从未超时 |
| recover（总线恢复） | **0 次** | ✅ 从未卡死 |

**重大发现：原判断错误修正**

我原先怀疑"400 kHz 在排线上信号完整性差"，**这是错的**。
实测 **400 kHz 同样 0 失败**。

真正的根因是：**原驱动在所有超时路径直接 `return 0`，不发 STOP → 一次失败就把总线永久拉死**。
一旦卡死，之后每次读都失败，`angle` 就恒为 0 / NaN。

**修复三要素**（`app/encoder.c`）
1. 每个等待点都有有限超时，超时后**必发 STOP**释放总线
2. 失败返回**明确错误码**，绝不返回 0 冒充有效角度
3. 数据校验：双读一致性 + 跳变丢弃 + 统计（abort/recover/outlier）

**仍有待关注的问题：磁场偏弱**

```
STATUS=0x33  AGC=128  MAGNITUDE=909
  MD=1（检测到磁铁）  ML=1（磁场太弱❗）  MH=0
```

`ML=1` 且 `AGC=128`（正常应接近 0）说明**磁铁与芯片间距偏远**。
虽然角度读数稳定，但弱磁场可能导致**角度非线性/精度下降**，
影响 FOC 换相质量。**建议在进入阶段 3 对齐前先处理**：

- 把磁铁往芯片方向靠近（目标 AGC 降到 0~50，ML 清零）
- 或确认厂家预装磁铁是否松动/错位

---

### 阶段 2 — 引入 FOC 库并安全共存（1 天）

**目标**：让 SimpleFOC 库可以运行，但**先不闭环**，确认不会像之前那样卡死

**背景**：之前诊断固件反复卡死（PC 停在 `b.n` 自循环），确认是
SimpleFOC 库与自写代码混用时的状态干扰。必须重新设计集成方式。

**任务**
- [ ] 以 `reference/SimpleFOC_port` 为基础，**把已修复的 4 个 bug 固化进去**
  - `setPhaseVoltage` 写 **TIM1**（已修）
  - `SystemInit` → 显式配置 72MHz（已修）
  - I2C 超时清理（阶段 1 会重写，这里对接）
  - 电流零点在 EN 之后标定
- [ ] **加看门狗**（IWDG）：防止卡死后电机持续通电
- [ ] 库只跑"空转"测试：`loopFOC()` 空跑，目标恒为 0，观察是否稳定
- [ ] 确认 `shaft_angle`、`shaft_velocity` 不再出现 NaN

**验收**
- `loopFOC()` 连续运行 **30 分钟**不卡死
- 目标恒 0 时电机不转、电流 < 0.2 A
- 编码器读数在库环境下仍然可靠（复用阶段 1 的统计）

**停止条件**：仍出现卡死 → 说明库集成有问题，需要进一步隔离（例如把 FOC 计算放到定时器中断里，与主循环解耦）

**产出**：`app/foc_closedloop.c` —— 可稳定运行的空转闭环框架

---

#### 阶段 2 实施记录（进行中）

**集成方式（关键设计）**

参考工程的 `MyProject.h` 会把 `iic.h` 一起包含进来，导致**库直接操作 I2C** ——
而那个 I2C 驱动正是阶段 1 判定为"会卡死总线"的版本。

所以本工程采用**隔离式集成**：

| 文件 | 作用 |
|---|---|
| `app/MyProject.h` | **精简版**：去掉 iic.h/spi2.h，只保留库需要的类型、宏、全局变量声明 |
| `app/encoder.c/.h` | 阶段 1 验证过的健壮 I2C 驱动 |
| `app/foc_idle_test.c` | 把库的 `getAngle()`/`getVelocity()` 桥接到 `encoder.c` |
| `app/SimpleFOC/*` | 库源码（原样复制，仅 include 指向精简版 MyProject.h） |
| `app/Hardware/timer.c` `delay.c` | 原样复制 |

**这样库永远不碰 I2C，只用我们验证过的接口。**

**首次启动结果（✅ 不卡死）**

```
[1 s] angle=0.4602 vel=0.0000 Hz=1000 NaN=0 ok=4002 fail=0
[2 s] angle=0.4602 vel=0.0000 Hz=1000 NaN=0 ok=8002 fail=0

EN=OFF          ← 电机失能
CCR 0/0/0       ← PWM 全零
voltage.q=0.0000 voltage.d=0.0000
NaN count=0
encoder fail=0  abort=0  recover=0
loop: 1000 Hz
>>> HEALTHY
```

**发现并规避的一个严重隐患**

`FOCMotor.c` 里 `voltage` 是**全局未初始化变量**：

```c
DQVoltage_s voltage;   /* 无初值！ */
```

而 `loopFOC()` 会**无条件**执行：

```c
setPhaseVoltage(voltage.q, voltage.d, electrical_angle);
```

⇒ 如果不在使能前显式清零，**上电第一次 `loopFOC()` 就会把随机值写进 PWM**！
本固件已在 `motor_init` 后显式 `voltage.q = voltage.d = 0`。
**这一点在阶段 3/4 使能电机前必须再次确认。**

**实测到的两个待改进点（进入阶段 3 前处理）**

1. **主循环只有 1 kHz**，瓶颈是编码器 I2C 读取
   - 当前 `as5600_read_raw()` 分两次独立读（各含地址/寄存器/重复起始/停止）
   - 改进：合并成**一次 2 字节读**，预计可翻倍到 ~2 kHz
   - ⚠️ 注意：这属于**修改阶段 1 已验证的驱动**，必须重新跑
     `T20000` 压测确认错误率仍为 0

2. **`getVelocity()` 恒返回 0**（空转时无害，但闭环必需）
   - 根因：用了未递增的毫秒计数器，`dt ≈ 0` 被下限截断
   - 修复：改用 SysTick 自由计数时基
     `dt = (0xFFFFFF - SysTick->VAL) 差值 / 9e6`（9MHz）
   - 必须**先验证速度读数正确**（手动转轴看 vel 变化），再进阶段 4

---

### 阶段 3 — 对齐（★ 最危险的一步，1 天）

**目标**：让 `alignSensor()` 成功，得到 `sensor_direction` 与 `zero_electric_angle`

**为什么危险**
对齐会强制电机做开环旋转，且**在闭环代码路径里**。参数不对会让电流失控。

**任务**

1. **对齐参数收紧**
   - 对齐电压：从 **1.5 V** 起步（对应约 0.23 A），不够再逐步加
   - 必须 < `voltage_limit`
   - 限制对齐过程的总转角和持续时间

2. **每个对齐步内插入过流检查**
   ```
   for 每一步:
       setPhaseVoltage(align_v, angle)
       读电流 → 超限立即 EN 拉低 + 中止
       延时
   ```
   > 原库的 `alignSensor()` 内部是 `delay_ms(2)`，**没有电流检查**，
   > 必须在循环体里插入。

3. **分步观察**
   - 先只跑"前 500 步正转"，打印 mid/end 角度，确认能测到运动
   - 再跑完整对齐

4. **结果校验**
   - `sensor_direction` 必须是 ±1，不能是 0
   - `zero_electric_angle` 应落在 [0, 2π]
   - `PP check: OK!` 或打印出建议极对数

**验收**
- `sensor_direction = CW 或 CCW`（非 0）
- `zero_electric_angle` 是有限值
- 极对数校验通过（或按提示改正后通过）
- **全程最大电流 < 1.5 A**

**停止条件**
- 反复 `Failed to notice movement` → 编码器又不可信了，**回到阶段 1**
- 对齐时电流异常 → 立即停，检查对齐电压与电机接线

**产出**：对齐参数字典（记录成功的电压、耗时、方向、零点）

---

### 阶段 4 — 闭环三模式逐步验证（1~2 天）

**目标**：力矩 → 速度 → 位置，逐个跑通

#### 4.1 力矩模式（最先做，最好观察）

**为什么先做**：给固定电角度 → 转子锁在固定位置 → **不动 = 不会失步 = 最安全**

- 任务：给固定 `Uq`（从 1V 起）和固定电角度，观察转子是否锁住、电流是否与 `V/6.5` 吻合
- 验收：转子锁定不抖；电流符合 `I ≈ V/6.5`；松开后能保持位置
- 安全：`Uq` ≤ 2V，超流立即断

#### 4.2 速度模式

- 任务：从**很小的目标**开始（`T1` = 1 rad/s），PID 先给保守值
- 观察：响应方向对不对、有没有振荡、`shaft_velocity` 是否跟随
- 验收：能稳定跟随给定；无发散；**电流 < 1.4 A 额定**
- 安全：`velocity_limit` 先设小（如 10 rad/s）；目标值逐步加

#### 4.3 位置模式（最后做）

- 任务：给定阶跃目标，观察是否到位、有无过冲/振荡
- 验收：稳态误差可接受；无持续振荡；阶跃响应可重复
- 安全：阶跃幅度先小（±0.5 rad）

**PID 调参原则（安全第一）**
```
先 P 小、I=0、D=0  → 慢慢加 P 到刚好有响应
再加 I 消除稳态误差（注意积分饱和 → 库里有 antiwindup）
最后加 D 抑制过冲
每个参数只改一个，且每次改完先看电流
```

**产出**：三套可用的 PID 参数 + 每种模式的测试记录

---

### 阶段 5 — 电流保护接入闭环 + 精度复核（1 天）

**目标**：把已在六步换相中验证过的电流保护，**无缝搬进闭环**

**任务**
- [ ] 闭环循环内每周期检查电流，超阈值立即 EN 拉低
- [ ] 复核电流采样精度：**在 PWM 中点采样**（而不是我目前用的 DC 平均）
  - 闭环下 MOSFET 开关，CSA 输出会随 PWM 变化，中点采样才准
  - 用外部电流表对比标定 `A_per_count`
- [ ] 增加"堵转检测"：速度接近 0 但电流很大 → 判定堵转 → 停
- [ ] 增加"失步检测"：`shaft_velocity` 与目标差距过大且电流高 → 停

**验收**
- 人为堵转电机，保护在 100 ms 内切断
- 高速运行时电流读数与实际吻合（误差 < 20%）

---

### 阶段 6 — 稳定固化与文档（0.5 天）

**目标**：把可用状态固化并记录

**任务**
- [ ] 整理最终固件，所有安全参数集中到文件头
- [ ] 记录：可用的对齐电压、PID 参数、各模式安全上限
- [ ] 更新 `docs/` 与 README 的「已验证 / 待办」表
- [ ] 提交并推送
- [ ] 写「G431 移植对照表」：引脚差异、时钟差异、需要改的地方

**验收**
- 新烧录的板子按文档操作可复现闭环

---

## 三、安全设计总表

| 层 | 措施 | 触发条件 | 动作 |
|---|---|---|---|
| 1 | **电源限流** | 实验室电源设 1.5 A | 硬件兜底 |
| 2 | **软件过流** | 电流 > 1.5 A | 立即 EN 拉低 |
| 3 | **电压上限** | `voltage_limit` ≤ 5 V | 限制最大电流 |
| 4 | **速度上限** | `velocity_limit` 从 10 rad/s 起 | 防飞车 |
| 5 | **看门狗** | 主循环卡死 | 复位 |
| 6 | **数据校验** | 编码器读数异常 | 拒绝该次数据 |
| 7 | **失步/堵转检测** | 目标与反馈背离 + 高电流 | 停机 |
| 8 | **急停命令** | 串口 `D` | 立即 EN 拉低 |
| 9 | **可回退固件** | 任何异常 | 烧回 `mini.hex` |

**每一层都要独立可验证** —— 这是"安全性第一"的具体含义。

---

## 四、风险登记

| 风险 | 概率 | 影响 | 缓解措施 |
|---|---|---|---|
| **编码器不可靠** | 中 | **高**（换相错乱→大电流） | 阶段 1 专门攻坚；备选 PWM/换编码器 |
| 对齐时电流失控 | 中 | 高 | 对齐电压从 1.5V 起；步内插电流检查 |
| PID 振荡/发散 | 高 | 中 | 保守调参；每步看电流；限速限压 |
| 库集成再次卡死 | 中 | 中 | 阶段 2 空转 30 分钟验证 + 看门狗 |
| 电流采样在闭环下不准 | 中 | 中 | 阶段 5 用 PWM 中点采样 + 外部表标定 |
| 电机已有损伤 | 低 | 中 | 测空载电流是否仍 ≈ 0.1 A |

---

## 五、时间估算与里程碑

```
阶段 0  基线与安全网        0.5 天   → 里程碑: 可回退
阶段 1  编码器可靠性 ★      1~2 天   → 里程碑: 错误率 < 0.1%  【关键门】
阶段 2  库集成能稳定运行    1 天     → 里程碑: 空转 30min 不卡
阶段 3  对齐成功 ★          1 天     → 里程碑: sensor_direction ≠ 0
阶段 4  三模式验证          1~2 天   → 里程碑: 速度/位置环可用
阶段 5  保护接入 + 精度     1 天     → 里程碑: 堵转 100ms 内切断
阶段 6  固化文档            0.5 天   → 里程碑: 可复现
────────────────────────────────────
合计约 6~8 天（按每天 4~6 小时有效工作时间）
```

**两个关键门（Gate）**：阶段 1 和阶段 3。任一门不过，其余都要等。

---

## 六、立即可以开始的三件事

1. **建编码器测试固件**（`encoder_test.c`）：只读角度、统计失败率、不接电机
   → 这是纯软件 + 串口的工作，**零硬件风险**
2. **确认上拉和线长**：量 PB6/PB7 上拉阻值，把排线尽量缩短
3. **把 `voltage_limit` 默认值改成 5V**，并在正式固件里加电流保护

---

## 七、与正式版（G431）的关系

测试版跑通后，正式版需要改的：

| 项目 | F103（测试版） | G431（正式版） |
|---|---|---|
| PWM | TIM1 CH1/2/3，PA8/9/10 | TIM1 CH1/2/3（**同一个定时器，改引脚**） |
| 时钟 | HSE 8MHz × 9 = 72MHz | HSE 8MHz + PLL → 170MHz |
| 电流采样 | ADC1 规则组 + DMA | **ADC1 注入组 + TIM1 触发**（更准） |
| FOC 库 | SimpleFOC 移植版 | 建议直接用官方 SimpleFOC 的 STM32G4 支持 |
| 编码器 | I2C1 (AS5600) | I2C1 或 SPI（MT6701） |

**所以测试版把闭环逻辑跑通，正式版主要是"换平台 + 换引脚"，算法层可复用。**
