SkyHao723/new_gimbal/docs/接线检查表.md

# 接线检查表（对照 `4_closeloop_M1_bluepill` 固件）

> 固件当前配置：**PWM = TIM1 的 PA8/PA9/PA10** · **EN = PB0** · **串口 = USART2 (PA2/PA3)** · **编码器 = I2C1 (PB6/PB7)** · **驱动电源 = 24 V**
> 上电第一行应打印：`Vbus=24.0V  vlim=12.0V  align=3.5V  pp=7`

---

## 一、总览图

```
                  ┌──────────────────────────────┐
                  │      STM32F103C8T6 蓝板       │
   驱动小板        │                              │      USB-TTL
   ┌────────┐     │                              │      ┌────────┐
   │ PWM1 ──┼─────┤ PA8   (TIM1_CH1)             │      │        │
   │ PWM2 ──┼─────┤ PA9   (TIM1_CH2)             │      │        │
   │ PWM3 ──┼─────┤ PA10  (TIM1_CH3)             │      │        │
   │ EN   ──┼─────┤ PB0   (GPIO 输出)            │      │        │
   │ GND  ──┼──┬──┤ GND                          │      │        │
   └────────┘  │  │                              │      │        │
   24V 电源 ───┘  │ PA2 ─────────────────────────┼──────┤ RXD    │
                  │ PA3 ─────────────────────────┼──────┤ TXD    │
   ┌────────┐     │ PB6 (I2C1_SCL) ──────────────┼──┐   │ GND ───┼──┐
   │ AS5600 │     │ PB7 (I2C1_SDA) ──────────────┼──┤   └────────┘  │
   │ SCL  ──┼─────┤                              │  │               │
   │ SDA  ──┼─────┤                              │  └───────────────┤
   │ VCC  ──┼──3.3V                              │                  │
   │ GND  ──┼──┬──────────────────────────────────┴──────────────────┘
   └────────┘  │
            【所有 GND 必须连在一起】
```

---

## 二、逐条核对

### 2.1 驱动小板（3 路 PWM + 使能）

| 驱动小板 | 蓝板引脚 | 核对 |
|---|---|---|
| PWM1 | **PA8** | ☐ |
| PWM2 | **PA9** | ☐ |
| PWM3 | **PA10** | ☐ |
| EN（使能） | **PB0** | ☐ |
| GND | **GND** | ☐ |
| 电源输入 | **24 V 独立电源** | ☐ |

### 2.2 USB-TTL 串口（**TX/RX 必须交叉**）

| USB-TTL | 蓝板引脚 | 核对 |
|---|---|---|
| RXD | **PA2**（MCU 的 TX） | ☐ |
| TXD | **PA3**（MCU 的 RX） | ☐ |
| GND | **GND** | ☐ |
| VCC | 不接（或用模块自供电） | ☐ |

> ⚠️ 串口**不能**接 PA9/PA10 —— 那两个脚现在是 PWM。

### 2.3 AS5600 编码器

| AS5600 | 蓝板引脚 | 核对 |
|---|---|---|
| SCL | **PB6** | ☐ |
| SDA | **PB7** | ☐ |
| VCC | **3.3 V** | ☐ |
| GND | **GND** | ☐ |

### 2.4 调试口

| 信号 | 蓝板引脚 | 核对 |
|---|---|---|
| SWDIO | **PA13** | ☐ |
| SWCLK | **PA14** | ☐ |
| NRST | **NRST** | ☐ |

### 2.5 电源

| 项目 | 要求 | 核对 |
|---|---|---|
| 驱动小板 | 24 V 独立电源 | ☐ |
| 蓝板供电 | **5 V 脚** 或 USB（**绝对不能进 24 V**） | ☐ |
| 编码器 | 3.3 V（由蓝板供） | ☐ |
| **所有 GND 共地** | 驱动板 / 蓝板 / TTL / 编码器 | ☐ |

---

## 三、最容易接错的 5 个点

| # | 错误 | 后果 |
|---|---|---|
| 1 | **串口接在 PA9/PA10** | 那两脚已是 PWM，串口收不到（你现在能通说明没踩） |
| 2 | **编码器接在 PA9/PA10** | 读不到角度 |
| 3 | **24 V 接到蓝板 5V 脚** | **烧板** |
| 4 | **驱动小板和蓝板没共地** | PWM 有波形但驱动板不认，电机不转 |
| 5 | **EN 极性反了** | 电机完全不转（EN 低有效的话，拉高反而是失能） |

---

## 四、电机为什么不转 —— 按这个顺序量

### 步骤 1：量 PWM 有没有输出

**点「手动相位测试 (W)」，同时用万用表直流档量：**

| 测点 | 正常值 | 说明 |
|---|---|---|
| PA8 / PA9 / PA10 对 GND | **0.5~2 V 之间的某个平均值** | 有 PWM 输出。如果全是 0 V 或全是 3.3 V 不动 → 固件没输出 |
| 驱动板 PWM1/PWM2/PWM3 输入脚 | 和上面一样 | 确认杜邦线导通 |

> 24 V 系统、对齐电压 3.5 V → 占空比 ≈ 3.5/24 ≈ 15%，所以万用表量到的是 **3.3 V × 15% ≈ 0.5 V** 左右的平均值。

### 步骤 2：量 EN 脚

| 测点 | 正常值 |
|---|---|
| 蓝板 PB0 对 GND | **3.3 V**（使能时） |
| 驱动板 EN 脚对 GND | **3.3 V**（和 PB0 一致，若不一致说明线断） |

### 步骤 3：量三相输出

**相位测试时，量驱动板的 OUTA/OUTB/OUTC 两两之间：**

| 结果 | 含义 |
|---|---|
| 有电压（不是 0 也不是 24 V） | 驱动级在工作 |
| 全是 0 V | 驱动板没输出 → EN 没生效 或 驱动板坏 |
| 全是 24 V | 驱动板直通 → **危险，立即断电** |

### 步骤 4：确认电机接线

- 三根相线**接到驱动板的 OUTA/OUTB/OUTC** 了吗？（顺序不影响能否转动）
- 电机线有没有断线？量任意两相之间的直流电阻，应该是**几欧姆**（三相之间数值接近）

---

## 五、两个最可疑的原因

### ① EN 极性

厂家小板的 EN 可能是**低有效**。你说过"使能之后 EN 电压有 3.3 V"，但**如果它是低有效，3.3 V 恰好是失能状态**。

**验证方法**：把 `MyProject.h` 里两行对调，重新编译烧录：

```c
#define M1_Enable    GPIO_ResetBits(GPIOB,GPIO_Pin_0);   //低电平使能
#define M1_Disable   GPIO_SetBits(GPIOB,GPIO_Pin_0);
```

或者干脆**把 EN 直接接 GND 试一次**（如果低有效，接 GND 就是使能）。

### ② 驱动小板需要额外供电

有些厂家的小板有**两路电源**：
- 一路是 **24 V 功率**（给 MOS）
- 一路是 **逻辑电源**（3.3 V 或 5 V，给板上的驱动芯片）

**如果逻辑电源没接，板上的栅极驱动芯片不工作，MOS 永远不导通** —— 表现就是"PWM 有波形、EN 有电平，但电机一动不动"。

看一下小板上有几个电源输入脚，或者有没有 5 V / VCC / VDD 之类的丝印。

---

## 六、请给我这些数据

1. **驱动小板上的丝印**（照片最好）—— 尤其是电源脚和 EN 的标注
2. **步骤 1 量到的 PWM 电压** = ?
3. **步骤 3 量到的三相输出电压** = ?
4. **电机任意两相之间的电阻** = ?

有这四个，基本能定位到具体环节。
