SkyHao723/new_gimbal/docs/到位收敛优化-2026-10-16.md

# 到位收敛优化（2026-10-16）

用户确认提速效果后，希望到达目标位置更干脆。本轮在 Keil5 工程调整速度积分和位置增益，
已编译、下载校验、完成短时实机复查。修改尚未提交，Git 已推送基线仍为 `8b74ca8`。

## 调整依据与参数

提速版约 2.51rad → 0 的复测中，规划结束时仍有运动方向的负积分输出；实际角度短暂越过
零点后，积分逐渐转为正值才回正。该记录支持积分恢复偏慢的判断，但没有完成物理模型辨识。

逐项比较速度积分 I=3、I=5，再比较位置 P=40；采用最后一组：

| 参数 | 上一轮提速版 | 本轮 |
|---|---:|---:|
| 速度 PI 的 P | 0.6 | 0.6 |
| 速度 PI 的 I | 2 | 5 |
| 位置 P | 30 | 40 |
| 测速低通时间常数 | 0.02s | 0.02s |
| 规划最高速度 / 加速度 / 减速度 | 6 / 8 / 4 | 6 / 8 / 4 |
| 初始电压上限 | 3V | 3V |

更快更新积分，减轻减速末段残留输出的影响；提高位置修正强度，缩小瞬态偏差。
没有新增到位模式、积分清零或位置死区；静止时仍连续闭环保持。
上电开环单圈自检沿用原参数，本次针对普通 T 命令。

## 实机对比

COM8 / 115200，V3、L20，每次约 4.5 秒后 D，确认 EN=OFF，关闭串口。
下载由 STM32CubeProgrammer / ST-Link 校验通过。

| 同起点约 2.508rad → 0 | 最大采样超调 | 规划结束 | 持续保持在 ±0.3° 内 | 规划结束后的额外收敛时间 |
|---|---:|---:|---:|---:|
| 原提速版 I=2、位置 P=30 | 1.67° | 1.391s | 1.938s | 0.547s |
| I=5、位置 P=30 | 0.79° | 1.391s | 1.688s | 0.297s |
| 本轮 I=5、位置 P=40 | 0.44° | 1.391s | 1.625s | 0.234s |

此组相同起点测试中，超调下降约 74%，末段额外收敛时间缩短约 57%。
I=3 的零点测试因下载后初始化故障中止准备动作，起点不同（约 3.062rad），不纳入同起点比较。

| 本轮复查动作 | 规划结束 | 持续保持在 ±0.3° 内 | 最大采样超调 | 最后一秒角度摆幅 |
|---|---:|---:|---:|---:|
| 约 -0.084rad → π | 1.578s | 1.562s | 0.18° | 0.000° |
| 约 3.062rad → 0，重复回零 | 1.531s | 1.750s | 0.44° | 0.086° |
| 约 -0.083rad → 0.2rad | 0.500s | 0.531s | 0.06° | 0.092° |
| 正向整圈 | 2.203s | 2.172s | 采样未见越过目标 | 0.000° |
| 反向整圈 | 2.203s | 2.187s | 采样未见越过目标 | 0.000° |

整圈速度规划时间与上一轮一致；本轮整圈保持在 ±0.3° 内的时刻约 2.17～2.19s，
上一轮不同起点记录约 2.13～2.14s，不能宣称所有动作都更快。本轮收益主要在零点末段收敛。

采样约 37Hz，AS5600 一个计数约 0.088°，串口打印角度保留四位小数，因此一个计数在 CSV 中
可能显示为 0.086° 或 0.092°。0.000° 表示采样显示分辨率内未变化，不代表机械绝对静止。
上述为有限工况测试，没有测量噪声、电流或负载变化；手感仍需用户体验。
D 后会松开漂向齿槽位置，该失能后的变化没有计入使能时到位表现。

原始 CSV 和统计：[measurements/2026-10-16-settling](measurements/2026-10-16-settling)。
原始串口日志及下载日志：`D:\dsh_build\releases\settle-response`。
一次 I=3 候选下载后报告 `FAULT sensor init`，脚本中止并确认失能；下载工具本身校验成功。
后续有效读取恢复，最终候选重启下载及短时测试未再报告故障；该启动故障的根因未定位。

## 验证与回退

Keil ARMCC 5.06 全量构建：0 Error / 0 Warning。
Code=14544、RO-data=592、RW-data=68、ZI-data=3924；Flash=15204 bytes，RAM=3992 bytes。
既有主机控制、294 组轨迹组合、连续重规划、多圈精度、生命周期和故障测试全部通过。
本轮仅调整控制参数，没有增加与常量重复的测试。

板上及备份：`D:\dsh_build\releases\gimbal-crisp-20261016`，含 HEX、AXF、参数快照。

```text
HEX SHA256=7D40D1549208FDCF4281AD270104F8C1A1A40326C9897D828AA1F37EAD4B68FB
```

上一轮提速备份：`D:\dsh_build\releases\gimbal-fast-20261016`。
已推送稳定版：`D:\dsh_build\releases\gimbal-8b74ca8`。
本轮结束已 D 并确认 EN=OFF，COM8 已释放。
