SkyHao723/new_gimbal/docs/hardware/g431-2026-10-16/can-power.png

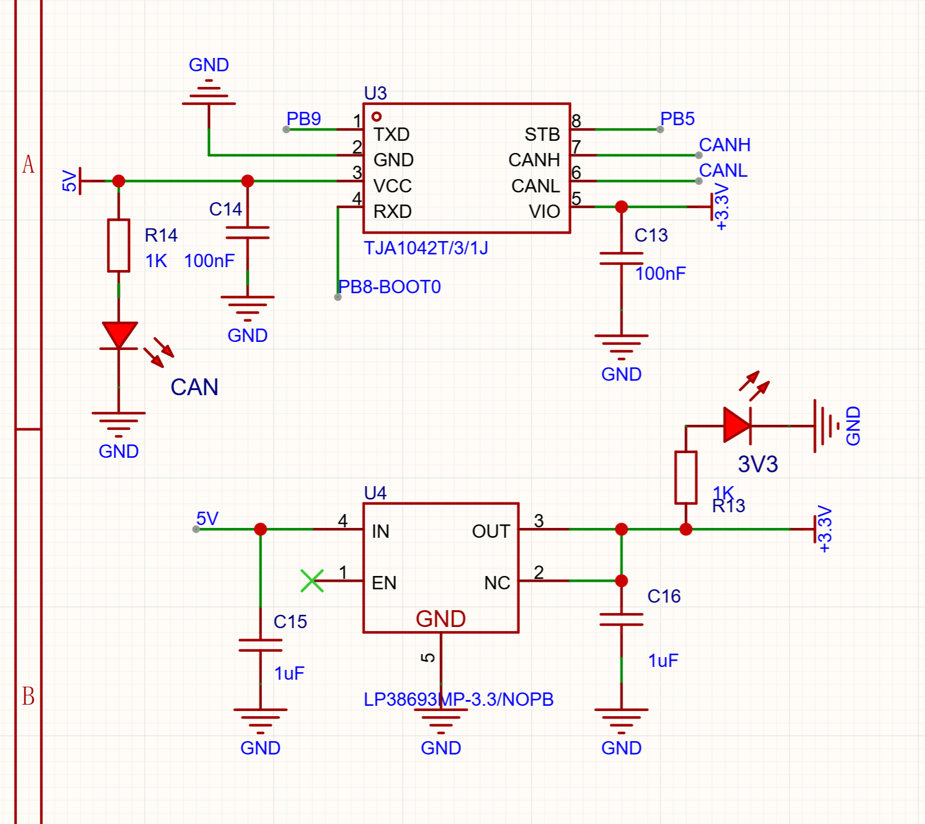
docs/hardware/g431-2026-10-16/can-power.png
