SkyHao723/new_gimbal/docs/hardware/g431-2026-10-16/connectors.png

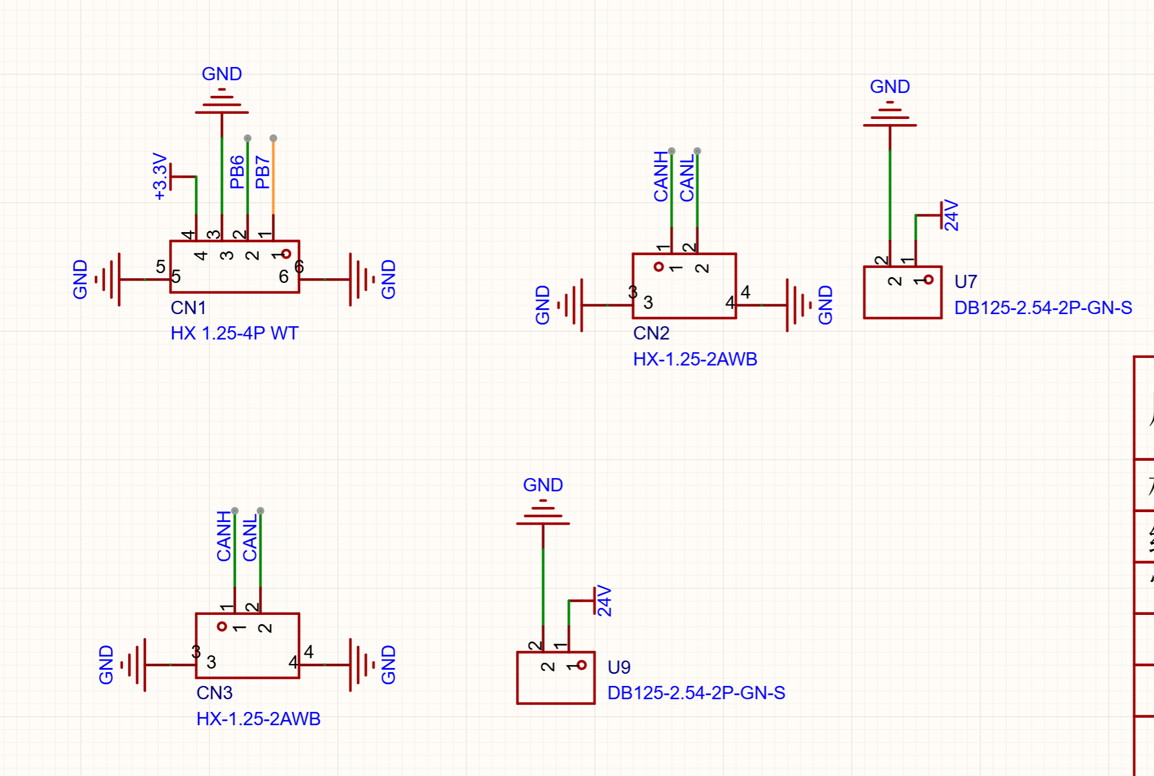
docs/hardware/g431-2026-10-16/connectors.png
