SkyHao723/new_gimbal/docs/hardware/g431-current-2026-10-20/page1-mcu.png

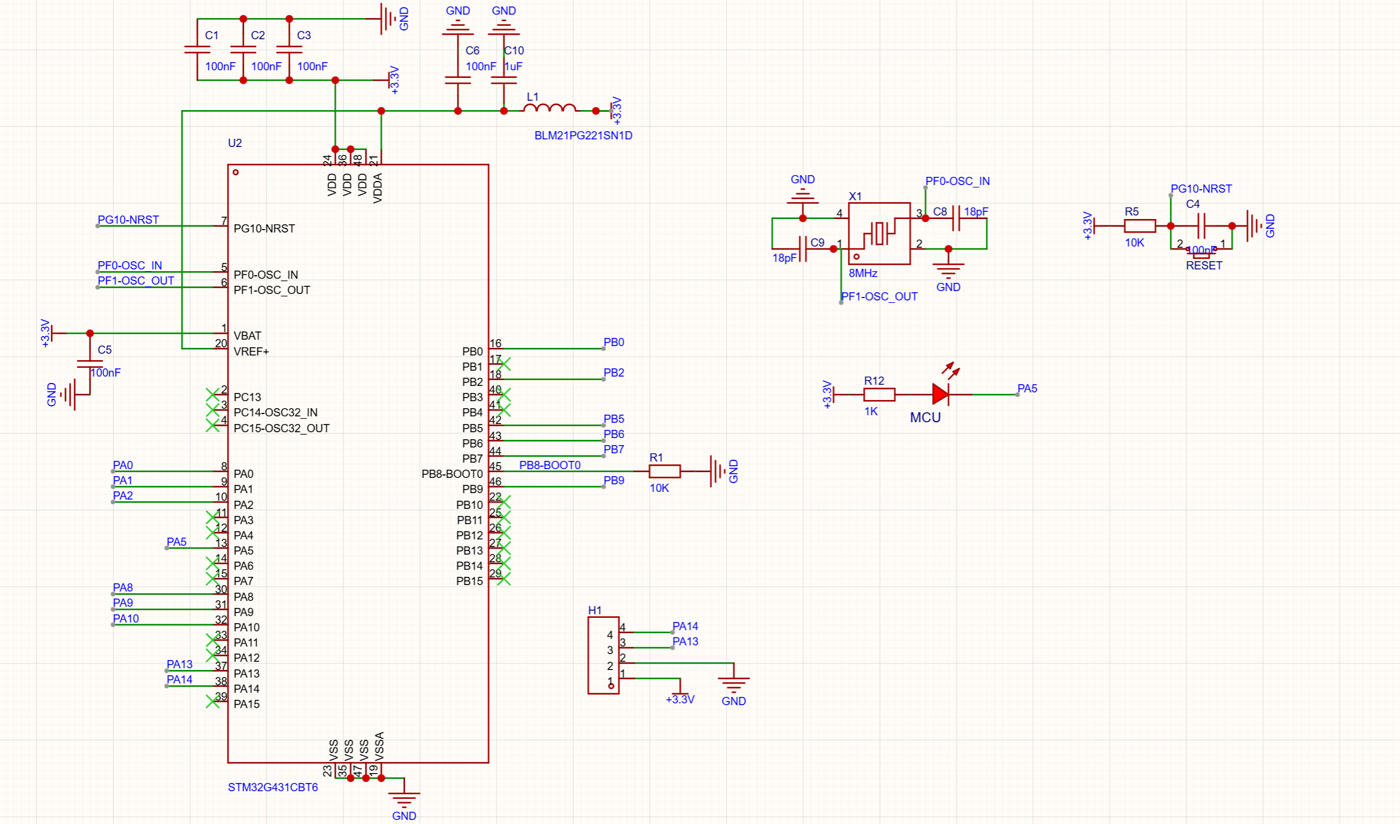
docs/hardware/g431-current-2026-10-20/page1-mcu.png
