SkyHao723/new_gimbal/docs/hardware/g431-current-2026-10-20/page2-driver.png

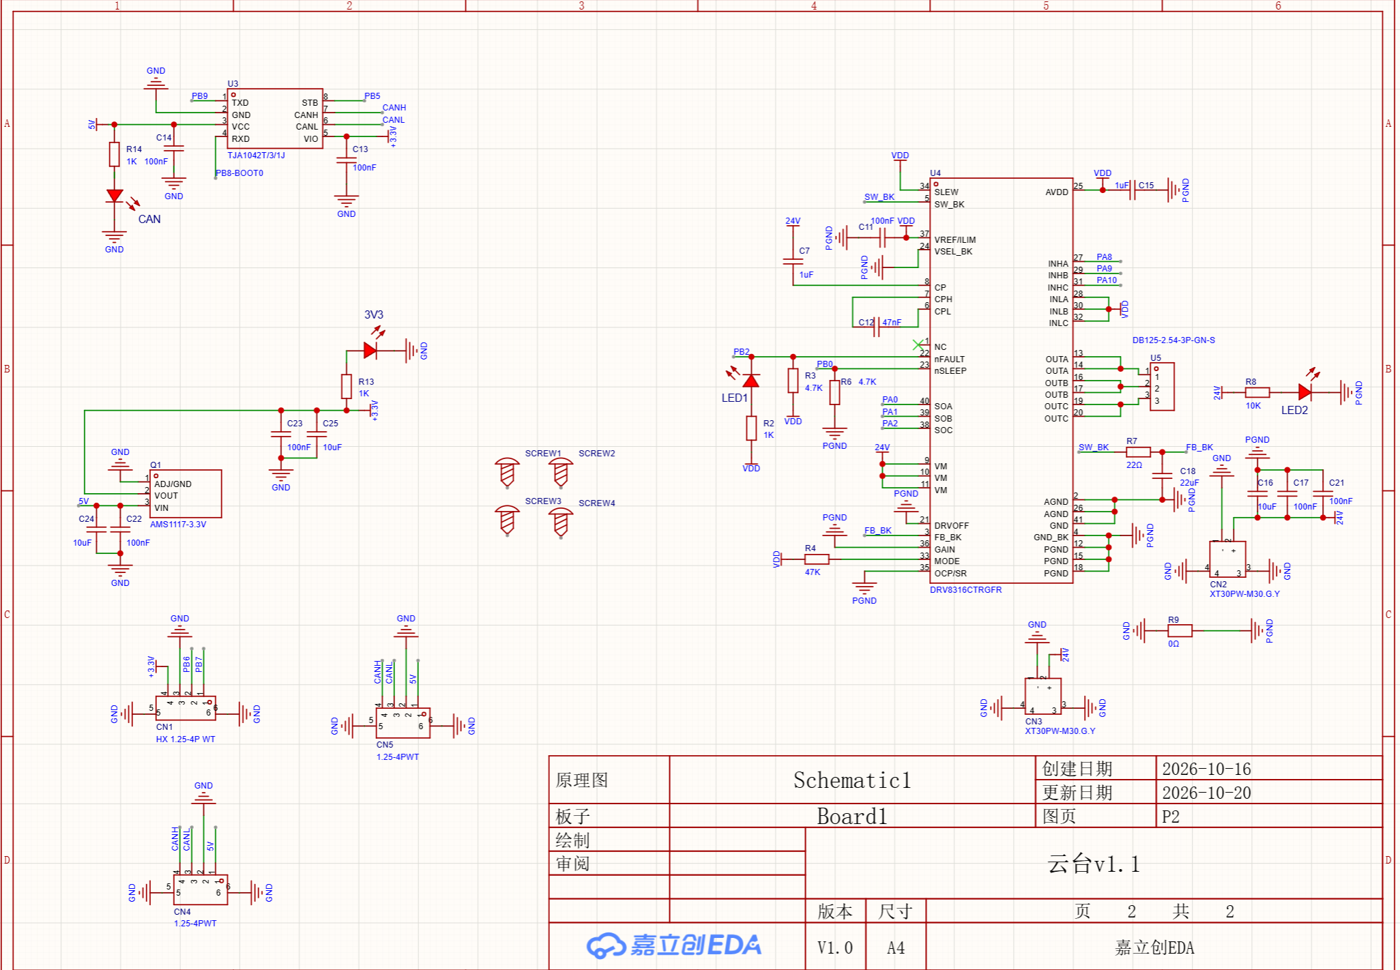
docs/hardware/g431-current-2026-10-20/page2-driver.png
