SkyHao723/new_gimbal/docs/hardware/icm42670-pinout-topview.png

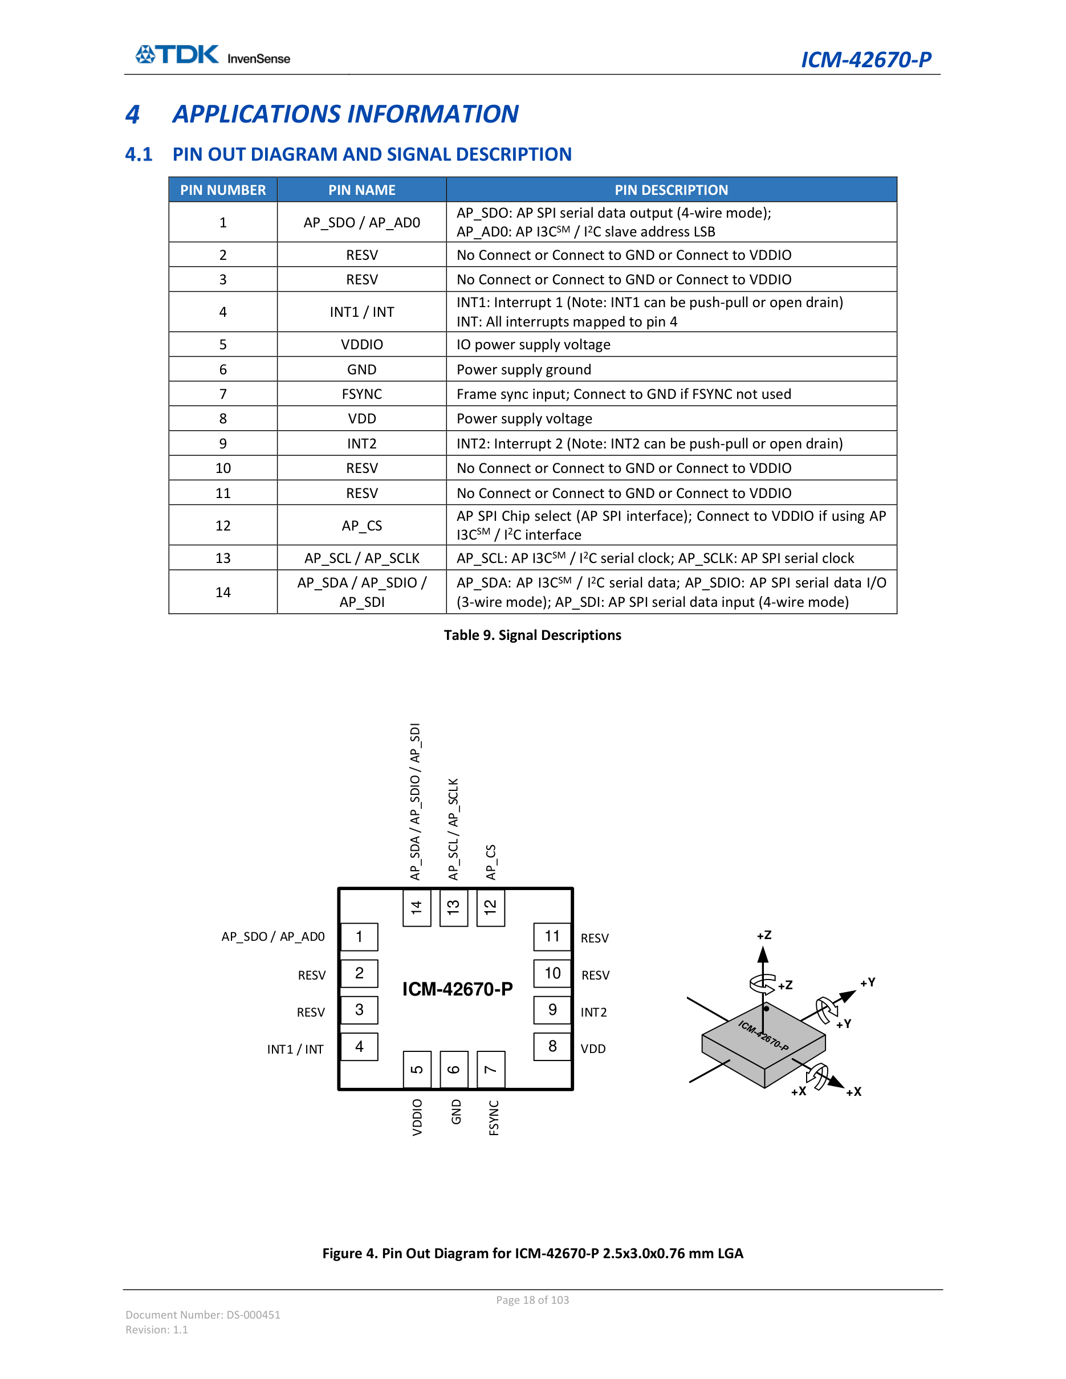
docs/hardware/icm42670-pinout-topview.png
