SkyHao723/new_gimbal/docs/measurements/2026-10-24-f103-baseline/README.md

# F103 当前参数实测基线（2026-10-24）

本次只核对参数、回读固件并运行位置运动，没有修改或烧录固件。TTL 为 COM9 / 115200，ST-Link 检出 F103 中容量、64KB Flash、目标电压 3.24V。每次先 D，确认失能，再设 V3 / L20，E 后发相对当前采样角度的绝对目标；小动作记录 3 秒，其余 4.5 秒，最后 D 并确认 EN=OFF。六次测试均正常结束，没有收到 FAULT。期间没有人为施加载荷。

## 参数与程序身份

| 参数 | 当前值 |
|---|---:|
| 速度 PI：P / I | 0.6 / 5 |
| 位置 P | 40 |
| 速度低通时间常数 | 0.02s |
| 轨迹最高速度 | 6rad/s |
| 加速度 / 减速度 | 8 / 4rad/s² |
| 速度环限速 L | 20rad/s |
| 默认电压上限 / 软件最高上限 | 3 / 5V |
| PWM / 编码器 I2C | 25kHz / 400kHz |
| 极对数 / 方向 / 电角度零点 | 11 / +1 / 0.92rad |

ST-Link 用 HOTPLUG 回读 64KB，未请求复位。回读内容与本地 `keil5_foc/Objects/gimbal_foc.hex` 的全部 15204 个有效字节一致。与 `D:/dsh_build/releases/gimbal-crisp-20261016/gimbal_foc.hex` 相比，仅 0x0800226C～0x0800226E 三个字节不同，该 32 位常量从 100000 变为 400000；两个参数快照也仅编码器 I2C 为 100kHz / 400kHz 的差别。本次短测未观察到编码器故障，未验证长期可靠性。

当前 HEX SHA256：`686840D439435A8F804497C956AC3FF8868AF77AB8C414CE7702D520BD86B7DD`。

回读备份为本目录 `flash-before.bin`，SHA256：`E5F254DFBF1C107AE1044E4DE8968199BAF078606C1B7A3824F2918BFA2DA2D6`。参数快照见 `motor_config_snapshot.h`。

## 实测结果

| 动作 | 规划结束 s | 进入并保持 ±0.3° s | 采样超调 ° | 最后 1 秒摆幅 ° | 峰值电压指令 V |
|---|---:|---:|---:|---:|---:|
| 反向 0.2rad | 0.422 | 0.437 | 0.052 | 0.086 | 0.577 |
| 正向 0.2rad | 0.422 | 0.359 | 0.052 | 0.086 | 0.678 |
| 反向半圈 | 1.563 | 1.531 | 0.000 | 0.000 | 1.949 |
| 正向半圈 | 1.562 | 1.531 | 0.000 | 0.000 | 1.409 |
| 反向整圈 | 2.204 | 2.188 | 0.000 | 0.000 | 1.781 |
| 正向整圈 | 2.203 | 2.156 | 0.000 | 0.000 | 1.750 |

## 判断与优化方向

当前 PI 与位置 P 在这些工况下配合正常：跟踪误差的采样峰值约 0.53～1.10°，末段没有明显来回摆动。正反整圈规划约 2.20 秒，实际进入 ±0.3° 约 2.16～2.19 秒，因此这组整圈动作的时间主要受轨迹规划约束。盲目提高 PI/P 并不能显著突破规划时长。

轨迹从静止运动 2π 时，按加速 8、减速 4 计算的三角形峰速为 sqrt(2×8×4×2π/(8+4))≈5.79rad/s，尚未触及 6rad/s 的巡航限制；单独提高最高轨迹速度，对本次半圈和整圈动作理论上几乎没有收益。若优先提速，应在维持末段稳定的前提下比较加减速度；若优先柔和，应比较限制加速度变化率的轨迹。到位干脆程度则需要加入不同停止角度和方向的重复测试。

## 数据解释与边界

- 状态采样约 37Hz，未捕捉到的短促超调不能排除。进入并保持指本次记录剩余期间均在 ±0.3° 内；不是无限时间保证。
- 角度来自 AS5600，12 位约 0.088°/计数。摆幅 0.000° 只代表采样显示未变，不能据此声称机械绝对静止或绝对定位达到该精度。
- 时间从脚本发送目标后开始计，包含串口与主机调度影响。规划结束也取首次观测，不是板端精确时间戳。
- 各动作相对于当次起点，失能后会有齿槽回落，不属于使能保持误差。最终 EN=OFF 的角度未纳入运动统计。
- uq 是控制输出电压指令，没有测量实际相电压、相电流、噪声、温度或负载性能。采样最大 |uq| 为 1.949V，没有观察到 3V 限幅；此结论不排除采样之间存在峰值。
- 当前仍是电压力矩控制，没有电流闭环；上电单圈自检仍启用。本轮没有复位来触发自检。

原始记录为同目录 `baseline-*.json`、`.log`、`.csv`，汇总为 `summary.json`。现有采集脚本为 `tools/diagnostics/position_response.py`。本次结束已失能并释放 COM9。
