SkyHao723/new_gimbal/docs/measurements/2026-10-27-g431-limit-trip/run-trip.csv

allowed | angle | enabled | fault | idx | ok | pk | req | samples | t | target_cmd | tgt | thermal | trips | vel | vlim
8.0 | -2.5096 | True | 1 | 0 |  | 0.06 | 8.0 | 1925914 | 0.828 | -2.1433 | -2.1433 | 0.0 | 0 | 1.3731 | 8.0
8.0 | -2.7719 | True | 1 | 1 |  | 0.07 | 8.0 | 1967229 | 1.656 | -6.1433 | -6.1433 | 0.0 |  | -2.317 | 8.0
8.0 | -4.3289 | True | 1 | 2 | 1 | 0.05 | 8.0 | 2008539 | 2.485 | -2.1433 | -2.1433 | 0.0 |  | -0.1677 | 8.0
8.0 | -5.9012 | True | 1 | 3 | 1 | 0.08 | 8.0 | 2049847 | 3.297 | -6.1433 | -6.1433 | 0.0 |  | -1.4714 | 8.0
8.0 | -5.2247 | False | 1 | 4 | 1 | 0.31 | 8.0 | 2091384 | 4.141 | -2.1433 | -5.2631 | 0.0 | 0 | 3.5008 | 8.0
8.0 | -5.2263 | False | 1 | 5 | 1 | 0.0 | 8.0 | 2133324 | 4.969 | -6.1433 | -6.1433 | 0.0 | 0 | 0.0 | 8.0
8.0 | -5.2263 | False | 1 | 6 |  | 0.0 | 8.0 | 2174642 | 5.797 | -2.1433 | -2.1433 | 0.0 | 0 | 0.0 | 8.0
8.0 | -5.2263 | False | 1 | 7 |  | 0.0 | 8.0 | 2215960 | 6.625 | -6.1433 | -6.1433 | 0.0 | 0 | 0.0 | 8.0
8.0 | -5.2263 | False | 1 | 8 |  | 0.0 | 8.0 | 2257278 | 7.453 | -2.1433 | -2.1433 | 0.0 | 0 | 0.0 | 8.0
8.0 | -5.2263 | False | 1 | 9 |  | 0.0 | 8.0 | 2298596 | 8.281 | -6.1433 | -6.1433 | 0.0 | 0 | 0.0 | 8.0
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
