SkyHao723/new_gimbal/docs/measurements/2026-10-27-g431-limit-trip/run.csv

allowed | angle | enabled | fault | idx | ok | pk | req | samples | t | target_cmd | tgt | thermal | trips | vel | vlim
7.96 | -3.249 | True | 1 | 0 |  | 0.12 | 8.0 | 359976 | 1.015 | -3.2455 | -3.2455 | 0.0 | 0 | 0.0526 | 7.96
7.93 | -5.4027 | True | 1 | 1 |  | 0.13 | 8.0 | 411334 | 2.046 | -5.6455 | -5.6455 | 0.0 | 0 | -1.0766 | 7.93
7.39 | -4.1141 | True | 1 | 2 | 1 | 0.18 | 8.0 | 462694 | 3.078 | -3.2455 | -3.2455 | 0.0 | 0 | 2.3362 | 7.39
8.0 | -3.7935 | True | 1 | 3 |  | 0.11 | 8.0 | 514072 | 4.093 | -5.6455 | -5.6455 | 0.0 | 0 | -2.49 | 8.0
7.87 | -4.9916 | True | 1 | 4 | 1 | 0.13 | 8.0 | 565434 | 5.125 | -3.2455 | -3.2455 | 0.0 | 0 | 1.6988 | 7.87
8.0 | -5.3521 | True | 1 | 5 |  | 0.11 | 8.0 | 616800 | 6.156 | -5.6455 | -5.6455 | 0.0 | 0 | -1.3091 | 8.0
8.0 | -4.1832 | True | 1 | 6 | 1 | 0.12 | 8.0 | 668160 | 7.187 | -3.2455 | -3.2455 | 0.0 | 0 | 3.6086 | 8.0
7.73 | -3.6969 | True | 1 | 7 |  | 0.15 | 8.0 | 719544 | 8.203 | -5.6455 | -5.6455 | 0.0 | 0 | -2.8423 | 7.73
8.0 | -4.5068 | True | 1 | 8 | 1 | 0.12 | 8.0 | 770910 | 9.234 | -3.2455 | -3.2455 | 0.0 | 0 | 2.9432 | 8.0
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
