SkyHao723/new_gimbal/docs/measurements/2026-10-27-g431-thermal/run.csv

allowed | angle | enabled | fault | idx | ok | pk | req | samples | t | target_cmd | tgt | thermal | trips | vel | vlim
8.0 | -2.0586 | True | 1 | 0 |  | 0.12 | 8.0 | 19831113 | 1.234 | -1.9992 | -1.9992 | 0.0 | 0 | 0.695 | 8.0
8.0 | -5.4594 | True | 1 | 1 | 1 | 0.09 | 8.0 | 19892410 | 2.453 | -6.9992 | -6.9992 | 0.0 | 0 | -3.7616 | 8.0
8.0 | -6.5164 | True | 1 | 2 |  | 0.08 | 8.0 | 19953714 | 3.687 | -1.9992 | -1.9992 | 0.0 | 0 | 2.3433 | 8.0
8.0 | -6.0853 | True | 1 | 3 | 1 | 0.08 | 8.0 | 20015020 | 4.906 | -6.9992 | -6.9992 | 0.0 | 0 | -2.6581 | 8.0
8.0 | -5.7984 | True | 1 | 4 |  | 0.19 | 8.0 | 20076316 | 6.14 | -1.9992 | -1.9992 | 0.0 | 0 | 3.5902 | 8.0
8.0 | -2.9989 | True | 1 | 5 |  | 0.09 | 8.0 | 20137646 | 7.359 | -6.9992 | -6.9992 | 0.0 | 0 | -0.1338 | 8.0
8.0 | -1.9972 | True | 1 | 6 | 1 | 0.02 | 8.0 | 20198896 | 8.578 | -1.9992 | -1.9992 | 0.0 | 0 | 0.0001 | 8.0
8.0 | -5.9043 | True | 1 | 7 | 1 | 0.12 | 8.0 | 20260185 | 9.812 | -6.9992 | -6.9992 | 0.0 | 0 | -2.6002 | 8.0
8.0 | -6.0531 | True | 1 | 8 |  | 0.17 | 8.0 | 20321484 | 11.031 | -1.9992 | -1.9992 | 0.0 | 0 | 3.4035 | 8.0
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
