SkyHao723/new_gimbal/docs/measurements/2026-10-16-motion/baseline-f888ddb.csv

phase | t | target | angle | velocity | enabled
outward | 0.01500000013038516 | 11.2447 | 11.0447 | -0.0 | ON
outward | 0.0470000000204891 | 11.2447 | 11.0508 | 0.1047 | ON
outward | 0.06200000015087426 | 11.2447 | 11.0999 | 0.8687 | ON
outward | 0.0940000000409782 | 11.2447 | 11.172 | 1.7003 | ON
outward | 0.10899999993853271 | 11.2447 | 11.1858 | 1.2756 | ON
outward | 0.14000000013038516 | 11.2447 | 11.1904 | 0.8893 | ON
outward | 0.1559999999590218 | 11.2447 | 11.1965 | 0.6578 | ON
outward | 0.1720000000204891 | 11.2447 | 11.2027 | 0.5155 | ON
outward | 0.2029999999795109 | 11.2447 | 11.2088 | 0.4256 | ON
outward | 0.2190000000409782 | 11.2447 | 11.2149 | 0.3619 | ON
outward | 0.25 | 11.2447 | 11.2241 | 0.3746 | ON
outward | 0.26500000013038516 | 11.2447 | 11.2364 | 0.435 | ON
outward | 0.2970000000204891 | 11.2447 | 11.2625 | 0.7045 | ON
outward | 0.31200000015087426 | 11.2447 | 11.2932 | 0.9077 | ON
outward | 0.3440000000409782 | 11.2447 | 11.2901 | 0.5279 | ON
outward | 0.3589999999385327 | 11.2447 | 11.2886 | 0.302 | ON
outward | 0.39000000013038516 | 11.2447 | 11.284 | 0.1121 | ON
outward | 0.4059999999590218 | 11.2447 | 11.2794 | -0.006 | ON
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
