SkyHao723/new_gimbal/docs/measurements/2026-10-16-motion/candidate-accel4.csv

phase | t | target | angle | velocity | enabled
outward | 0.014999999897554517 | 5.6134 | 5.4134 | 0.1363 | ON
outward | 0.04600000008940697 | 5.6134 | 5.415 | 0.1114 | ON
outward | 0.06199999991804361 | 5.6134 | 5.415 | 0.0734 | ON
outward | 0.0779999999795109 | 5.6134 | 5.415 | 0.0472 | ON
outward | 0.10899999993853271 | 5.6134 | 5.4165 | 0.0543 | ON
outward | 0.125 | 5.6134 | 5.4196 | 0.0845 | ON
outward | 0.1559999999590218 | 5.6134 | 5.4272 | 0.1747 | ON
outward | 0.17100000008940697 | 5.6134 | 5.4395 | 0.3086 | ON
outward | 0.2029999999795109 | 5.6134 | 5.4518 | 0.3914 | ON
outward | 0.21800000010989606 | 5.6134 | 5.4809 | 0.73 | ON
outward | 0.25 | 5.6134 | 5.5407 | 1.4381 | ON
outward | 0.2649999998975545 | 5.6134 | 5.6006 | 1.8742 | ON
outward | 0.2809999999590218 | 5.6134 | 5.6067 | 1.2657 | ON
outward | 0.3119999999180436 | 5.6134 | 5.6067 | 0.8024 | ON
outward | 0.3279999999795109 | 5.6134 | 5.6067 | 0.5092 | ON
outward | 0.3589999999385327 | 5.6134 | 5.6067 | 0.3231 | ON
outward | 0.375 | 5.6134 | 5.6067 | 0.2075 | ON
outward | 0.4059999999590218 | 5.6134 | 5.6067 | 0.1313 | ON
outward | 0.42100000008940697 | 5.6134 | 5.6067 | 0.084 | ON
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
