SkyHao723/new_gimbal/docs/measurements/2026-10-16-motion/candidate-trapezoid.csv

phase | t | target | angle | velocity | enabled
outward | 0.014999999897554517 | 5.2882 | 5.0882 | 0.1598 | ON
outward | 0.030999999959021807 | 5.2882 | 5.0882 | 0.1014 | ON
outward | 0.06199999991804361 | 5.2882 | 5.0882 | 0.063 | ON
outward | 0.0779999999795109 | 5.2882 | 5.0913 | 0.0865 | ON
outward | 0.10899999993853271 | 5.2882 | 5.099 | 0.1844 | ON
outward | 0.125 | 5.2882 | 5.1281 | 0.6034 | ON
outward | 0.1559999999590218 | 5.2882 | 5.1588 | 0.8458 | ON
outward | 0.17100000008940697 | 5.2882 | 5.1741 | 0.7928 | ON
outward | 0.1869999999180436 | 5.2882 | 5.1925 | 0.8063 | ON
outward | 0.21800000010989606 | 5.2882 | 5.2217 | 1.0023 | ON
outward | 0.2339999999385327 | 5.2882 | 5.2907 | 1.7444 | ON
outward | 0.2649999998975545 | 5.2882 | 5.3214 | 1.5415 | ON
outward | 0.2809999999590218 | 5.2882 | 5.3198 | 0.9559 | ON
outward | 0.3119999999180436 | 5.2882 | 5.3198 | 0.6106 | ON
outward | 0.3279999999795109 | 5.2882 | 5.3152 | 0.3199 | ON
outward | 0.3589999999385327 | 5.2882 | 5.3106 | 0.1307 | ON
outward | 0.375 | 5.2882 | 5.3076 | 0.036 | ON
outward | 0.4059999999590218 | 5.2882 | 5.3045 | -0.021 | ON
outward | 0.42100000008940697 | 5.2882 | 5.2999 | -0.084 | ON
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
