SkyHao723/new_gimbal/docs/measurements/2026-10-16-position-response/before-diag-reverse.csv

angle | vel | tgt | Vlim | Vbus | dir | zero | ref | rv | uq | ui | enabled | t
3.4254 | 0.0686 | 1.5 | 3.0 | 24.0 | 1.0 | 0.92 | 3.4254 | -0.0039 | -0.023 | -0.008 | ON | 0.01500000013038516
3.4254 | 0.0399 | 1.5 | 3.0 | 24.0 | 1.0 | 0.92 | 3.4238 | -0.112 | -0.061 | -0.025 | ON | 0.0470000000204891
3.4238 | -0.0037 | 1.5 | 3.0 | 24.0 | 1.0 | 0.92 | 3.4193 | -0.2207 | -0.121 | -0.059 | ON | 0.06200000015087426
3.4162 | -0.125 | 1.5 | 3.0 | 24.0 | 1.0 | 0.92 | 3.4118 | -0.3295 | -0.161 | -0.102 | ON | 0.0940000000409782
3.3947 | -0.4267 | 1.5 | 3.0 | 24.0 | 1.0 | 0.92 | 3.4013 | -0.4389 | -0.104 | -0.128 | ON | 0.125
3.3502 | -0.8586 | 1.5 | 3.0 | 24.0 | 1.0 | 0.92 | 3.3881 | -0.5463 | 0.218 | 0.004 | ON | 0.1559999999590218
3.3502 | -0.5011 | 1.5 | 3.0 | 24.0 | 1.0 | 0.92 | 3.3717 | -0.6552 | 0.149 | 0.094 | ON | 0.1720000000204891
3.3471 | -0.3515 | 1.5 | 3.0 | 24.0 | 1.0 | 0.92 | 3.3528 | -0.7619 | 0.027 | 0.086 | ON | 0.2029999999795109
3.3425 | -0.2798 | 1.5 | 3.0 | 24.0 | 1.0 | 0.92 | 3.3306 | -0.8709 | -0.159 | 0.007 | ON | 0.2339999999385327
3.3349 | -0.2842 | 1.5 | 3.0 | 24.0 | 1.0 | 0.92 | 3.3053 | -0.98 | -0.397 | -0.14 | ON | 0.26500000013038516
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
