SkyHao723/new_gimbal/docs/measurements/2026-10-16-position-response/before-pi.csv

angle | vel | tgt | Vlim | Vbus | dir | zero | enabled | t
1.511 | 0.0 | 3.1416 | 3.0 | 24.0 | 1.0 | 0.92 | ON | 0.0
1.511 | 0.0 | 3.1416 | 3.0 | 24.0 | 1.0 | 0.92 | ON | 0.031999999890103936
1.511 | 0.0 | 3.1416 | 3.0 | 24.0 | 1.0 | 0.92 | ON | 0.0470000000204891
1.5125 | 0.0259 | 3.1416 | 3.0 | 24.0 | 1.0 | 0.92 | ON | 0.07899999991059303
1.514 | 0.042 | 3.1416 | 3.0 | 24.0 | 1.0 | 0.92 | ON | 0.09399999980814755
1.5171 | 0.0772 | 3.1416 | 3.0 | 24.0 | 1.0 | 0.92 | ON | 0.125
1.5248 | 0.171 | 3.1416 | 3.0 | 24.0 | 1.0 | 0.92 | ON | 0.14099999982863665
1.5386 | 0.3361 | 3.1416 | 3.0 | 24.0 | 1.0 | 0.92 | ON | 0.1720000000204891
1.5647 | 0.6501 | 3.1416 | 3.0 | 24.0 | 1.0 | 0.92 | ON | 0.18799999984912574
1.6245 | 1.3679 | 3.1416 | 3.0 | 24.0 | 1.0 | 0.92 | ON | 0.21899999980814755
1.6337 | 1.0041 | 3.1416 | 3.0 | 24.0 | 1.0 | 0.92 | ON | 0.23499999986961484
1.6429 | 0.7926 | 3.1416 | 3.0 | 24.0 | 1.0 | 0.92 | ON | 0.25
1.6628 | 0.8271 | 3.1416 | 3.0 | 24.0 | 1.0 | 0.92 | ON | 0.28199999989010394
1.6874 | 0.919 | 3.1416 | 3.0 | 24.0 | 1.0 | 0.92 | ON | 0.2970000000204891
1.7181 | 1.0825 | 3.1416 | 3.0 | 24.0 | 1.0 | 0.92 | ON | 0.32899999991059303
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
