SkyHao723/new_gimbal/docs/measurements/2026-10-16-position-response/gains30-06-2-tf02-pi-from0.csv

angle | vel | tgt | Vlim | Vbus | dir | zero | ref | rv | uq | ui | enabled | t
-0.0844 | -0.0632 | 3.1416 | 3.0 | 24.0 | 1.0 | 0.92 | -0.0828 | 0.0039 | 0.068 | -0.0 | ON | 0.015999999828636646
-0.0828 | 0.0091 | 3.1416 | 3.0 | 24.0 | 1.0 | 0.92 | -0.0812 | 0.114 | 0.097 | 0.004 | ON | 0.04699999978765845
-0.0813 | 0.0456 | 3.1416 | 3.0 | 24.0 | 1.0 | 0.92 | -0.0767 | 0.2221 | 0.206 | 0.017 | ON | 0.0779999999795109
-0.0767 | 0.1557 | 3.1416 | 3.0 | 24.0 | 1.0 | 0.92 | -0.0692 | 0.3305 | 0.277 | 0.037 | ON | 0.10999999986961484
-0.0706 | 0.2249 | 3.1416 | 3.0 | 24.0 | 1.0 | 0.92 | -0.059 | 0.4369 | 0.399 | 0.064 | ON | 0.125
-0.0614 | 0.3367 | 3.1416 | 3.0 | 24.0 | 1.0 | 0.92 | -0.046 | 0.5432 | 0.499 | 0.098 | ON | 0.15699999989010394
-0.0491 | 0.4481 | 3.1416 | 3.0 | 24.0 | 1.0 | 0.92 | -0.0297 | 0.6519 | 0.611 | 0.14 | ON | 0.18799999984912574
-0.0337 | 0.5581 | 3.1416 | 3.0 | 24.0 | 1.0 | 0.92 | -0.0109 | 0.7584 | 0.716 | 0.185 | ON | 0.2029999999795109
-0.0077 | 0.851 | 3.1416 | 3.0 | 24.0 | 1.0 | 0.92 | 0.0107 | 0.8651 | 0.56 | 0.221 | ON | 0.23499999986961484
0.023 | 1.044 | 3.1416 | 3.0 | 24.0 | 1.0 | 0.92 | 0.0351 | 0.9711 | 0.411 | 0.238 | ON | 0.26599999982863665
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
