SkyHao723/new_gimbal/docs/调试成果-2026-10-15.md

# 2026-10-15 调试成果（已实测验证）

> 本文记录本轮两处**已实测验证**的修复，以及闭环控制的**真实状态**。
> 详细背景见上级目录的 `交接说明.md`。

---

## 一、修复 1：串口命令丢包 —— 已验证解决 ✅

### 根因

Arduino STM32 core 的串口命名与直觉**完全不同**：

```c
// cores/arduino/Serial.cpp
Uart Serial1(USART1);   // ← Serial1 是 USART1 (PA9/PA10)
Uart Serial2(USART2);   // ← Serial2 才是 USART2 (PA2/PA3)
```

**PA9/PA10 已被 PWM 占用**，所以之前用 `Serial1` 想接 USART2，
实际去操作 USART1 —— 等于用一个引脚被 PWM 抢走的串口收发，命令丢一半。

### 修复

`platformio.ini`：
```ini
build_flags =
    -O2
    -ffunction-sections
    -fdata-sections
    -Wall
    ; ---- 串口：启用 Serial2 = USART2 (PA2/PA3) ----
    -D HAVE_HWSERIAL2
    -D PIN_SERIAL2_TX=PA2
    -D PIN_SERIAL2_RX=PA3
```

`main.cpp`：把手写串口换成核心的 **`Serial2`**。

**注意**：不要定义 `HAVE_HWSERIAL1`，否则 `Serial1` 会去抢 PA9/PA10（PWM 引脚）。

### 实测结果（`test/serial.ps1`）

```
TEST 1 (20x R):                  20/20  OK
TEST 2 (20x ?):                  20/20  OK
TEST 3 (突发 10x R, 无延时):      10/10  OK

TEST 4: 参数命令真的生效
  set V2.5    -> status Vlim=2.50        ✅
  set V3      -> status Vlim=3.00        ✅
  set T1.234  -> target=1.2340, tgt=1.2340 ✅

RESULT: SERIAL FIX CONFIRMED - 100% reliable
```

**顺带收益**：Flash 占用从 83.9% 降到 **63.3%**（删掉手写串口代码）。

---

## 二、修复 2：对齐失败导致电机完全不动 —— 已验证解决 ✅

### 现象

```
aligned: dir=CCW
         zero_electric_angle=-12345.0000     ← NOT_SET 哨兵值
...
T5.3545  moved=0.0000  expected=0.30        ← 完全不动
```

`dir=0`(UNKNOWN) + `zero_electric_angle=-12345`(NOT_SET) 说明
**`initFOC()` 里的 `alignSensor()` 失败了** → FOC 不知道电角度零点
→ 交给驱动的电压相位是错的 → 电机不动。

### 根因

**对齐电压只有 1.0V，推不动转子。**

SimpleFOC 的对齐流程需要让转子**转一整圈**来测传感器方向：

```c
// BLDCMotor::alignSensor()
// 正转 500 步、反转 500 步，比较 mid_angle / end_angle 得出 sensor_direction
```

1.0V 正是前面实测"力矩不足、完全不动"的电压 —— 转子不转，
方向检测自然失败。

### 修复

```c
#define ALIGN_VOLTAGE   3.0f      /* 从 1.0f 提到 3.0f */
```

**原则：对齐电压必须 >= 能可靠推动转子的电压。**

### 实测结果

```
对齐前:  aligned: dir=CCW   zero_electric_angle=-12345.0000    ❌
对齐后:  aligned: dir=CW    zero_electric_angle=2.8256          ✅
```

---

## 三、闭环控制的真实状态

### 2026-10-15 使能瞬态修复

首次使能时如果 `target_angle` 仍为默认值 `0`，而转子当前机械角不在零点，位置环会立即产生大幅阶跃，表现为很大的嗡鸣和瞬时电流。现已在 `initFOC()` 后将初始目标设为当前 `motor.shaft_angle`；用户发送 `T<n>` 后才执行位置移动。

同时，`E` 命令已改为幂等：只有 OFF→ON 时调用 `motor.enable()`；重复收到 `E` 只返回
`EN already ON`，避免 SimpleFOC 重置 PID 造成额外的使能瞬态。

### 上电单圈自检（已实机验证）

`STARTUP_ROTATE_ONCE=1`：FOC 对齐完成后，先用 `4 rad/s` 开环磁场带动电机，
再以 AS5600 实际累计角度判断完成 `+2π`（机械 360°），误差约 `0.03 rad` 内自动失能。
动作有 10 秒超时，串口收到 `D` 或 `T<n>` 会立即中止。实机日志已出现
`startup rotate DONE (+360deg), motor DISABLED`。

### 能工作的部分 ✅

```
>>> ENABLE (base=7.0072)
    angle after enable = 6.9919

--- 小步移动 (0.2 rad)，每步保持 1.5s ---
  step 1: moved=0.2009  err=-0.0009      ← 误差 0.09%
  step 2: moved=0.2010  err=-0.0010      ← 误差 0.10%
  step 3: moved=0.2101  err=-0.0101      ← 误差 0.48%

--- 静止保持测试 3 秒 ---
  drift over 3s = 0.0000 rad             ← 完全无漂移 ✅
```

**小幅度移动精度极高（误差 < 0.5%），静止时完全稳定。**

### 不工作的部分 ❌

累积移动超过约 **0.6 rad** 后失稳：

```
  step 4: moved=0.9388  err=-0.7388      ← 乱甩（期望 0.2）
  step 5: moved=-0.7547 err=0.9547       ← 反向乱甩
```

### 根因分析

**速度环被编码器噪声污染。**

实测证据：电机静止时 `vel` 会乱跳：

```
EN=OFF  angle=4.844  vel=0.963
EN=OFF  angle=4.844  vel=2.726     ← 角度完全相同，速度却差 3 倍
EN=OFF  angle=4.844  vel=0.686
```

原因：AS5600 是 12 位（4096 线），`vel` 由角度差分得到。
角度只有 ±1 LSB 噪声时，差分测速会把噪声放大成 **2.7 rad/s 的假速度**。

速度环把这个假速度当成真实反馈 → 输出错误的电压 → 运动时失稳。
静止时不失稳是因为位置环的 P 增益把转子压住了。

### 极对数修正与最终闭环复测

SimpleFOC 对齐诊断曾报告 `est. pp: 11.28`，而 `POLE_PAIRS=7` 时为 `PP check: FAIL`。
改为 `POLE_PAIRS=11` 后变为 `PP check: OK`，这是大角度失步的根因。
同时保留 `4 rad/s` 目标斜坡，避免大角度命令瞬间饱和速度环。

最终固件实测：上电开环自检完成 `+360°` 后自动失能；从 `11.3484 rad` 发出
`+2π` 后到达 `17.6346 rad`，再发出 `-2π` 后回到 `11.3423 rad`，两次误差约 `0.01 rad`。
测试结束状态为 `EN=OFF`。

### 当前参数与后续调试参考

| 参数 | 当前值 | 建议方向 | 原因 |
|---|---|---|---|
| `LPF_velocity.Tf` | **0.05** | 已保留 | 更强的滤波压掉 AS5600 差分速度噪声 |
| `PID_velocity.P` | **0.2** | 已验证 | 提供足够起动/跟踪力矩 |
| `PID_velocity.I` | **5.0** | 已验证 | 消除持续位置误差 |
| `P_angle.P` | **20** | 已保留 | 配合目标斜坡使用 |
| `V_LIMIT` | **3.0V** | 已保留 | 约 0.79 A 安全上限 |

**调试方法**：用 `test/closedloop.ps1` 反复跑，看 `moved` vs `expected`
的偏差是否稳定。**每次只改一个参数。**

### 另外可考虑的方向

- **启用电流采样**：驱动板有 CS1/CS2/CS3 输出（接 PA0/PA1/PB1），
  改用 `TorqueControlType::foc_current` 可绕开速度环噪声问题
- **检查速度观测器**：SimpleFOC 的 `LPF_velocity` 是简单一阶低通，
  可以考虑换更平滑的测速方法

---

## 四、当前固件默认参数

速度环参数已根据实机极对数校验和正/反整圈实测调整；为保留当前硬件的安全余量，
电压上限仍固定为 3 V。

```c
#define POLE_PAIRS      11       /* 对齐实测约 11.28；官方 SimpleFOC Mini 例程也是 11 */
#define SUPPLY_VOLTAGE  24.0f
#define V_LIMIT_INIT    3.0f      /* 约 0.79A；1.5V 推不动 */
#define ALIGN_VOLTAGE   3.0f      /* 必须 >= 能推动转子的电压 */
#define VEL_LIMIT_INIT  20.0f

motor.PID_velocity.P = 0.2f;
motor.PID_velocity.I = 5.0f;
motor.PID_velocity.D = 0.0f;
motor.PID_velocity.output_ramp = 1000.0f;
motor.LPF_velocity.Tf = 0.05f;
motor.P_angle.P = 20.0f;
```

## 五、资源占用

```
RAM:   12.9% (2636 / 20480 bytes)
Flash: 63.3% (41516 / 65536 bytes)
```

## 六、测试脚本

| 脚本 | 用途 |
|---|---|
| `test/serial.ps1` | 串口可靠性测试（20 条命令 + 参数生效验证） |
| `test/closedloop.ps1` | 闭环移动/保持表征测试 |

两者都通过 COM8 直连（需先断开 Web 控制器占用的串口）。
