SkyHao723/new_gimbal/docs/调试总结与安全指南.md

# 电机调试总结与安全使用指南

> 硬件：STM32F103C8T6（蓝板）+ SimpleFOC Mini（DRV8316C）+ 云台电机（24V/1.4A/5.4Ω/33W）+ AS5600
> 状态：**已成功转起来，空载电流 < 0.1A**（标称空载 0.1A，完美）

---

## 一、最终接线

| 功能 | 引脚 | 说明 |
|---|---|---|
| PWM1 / PWM2 / PWM3 | **PA8 / PA9 / PA10** | TIM1_CH1/2/3，25 kHz 中心对齐 |
| EN（使能） | **PB0** | 高电平使能 |
| 串口 | **PA2(TX) / PA3(RX)** | USART2，115200 |
| 编码器 I2C | **PB6(SCL) / PB7(SDA)** | AS5600 |
| 电流采样 | **PA0 / PA1 / PB1** | CS1 / CS2 / CS3（DRV8316C 的 SOx） |
| SWD | PA13 / PA14 | 调试下载 |
| GND | 全部共地 | **必须** |

**电源**：驱动板进 24 V；蓝板用 USB 或 5 V 脚（**绝不能进 24 V**）。

---

## 二、电机参数（实测标定）

| 参数 | 值 | 来源 |
|---|---|---|
| 电源电压 | 24 V | 实测 |
| 额定电流 | 1.4 A | 厂家 |
| 堵转电流 | 4.9 A | 厂家 |
| 相电阻 | 5.4 Ω | 厂家 |
| **实测两相串联电阻** | **约 6.5 Ω** | 实测（见下表） |
| 功率 | 33 W | 厂家 |
| 空载电流 | **0.1 A** | 实测 ✓ |
| KV / 极对数 | 54 RPM/V / 7 | 厂家 |

### 实测电压-电流对照（转子锁定）

| 施加电压 | 实测电流 | 反推电阻 |
|---|---|---|
| 1.0 V | 0.142 A | 7.0 Ω |
| 1.5 V | 0.228 A | 6.6 Ω |
| 2.0 V | 0.317 A | 6.3 Ω |

**结论：`I ≈ V / 6.5`**，这个公式是所有电流安全计算的基础。

---

## 三、电压上限对照表（最重要！）

| voltage_limit | 预期电流 | 相对额定 1.4 A | 安全性 |
|---|---|---|---|
| 2 V | 0.31 A | 22% | ✅ 很安全 |
| **5 V** | **0.77 A** | **55%** | ✅ **推荐值** |
| 7 V | 1.08 A | 77% | ⚠️ 可以但注意温度 |
| **9 V** | **1.38 A** | **99%** | ⚠️ 正好额定，别再加 |
| 10 V | 1.54 A | 110% | ❌ 超额 |
| 15 V | 2.3 A | 165% | ❌❌ 会烧 |
| 24 V | 3.7 A | 264% | ❌❌❌ 堵转级 |

> ⚠️ **之前的严重错误**：我最初把 `voltage_limit` 设成 12 V，
> 对应约 1.85 A（132% 额定），叠加开环失步后电流冲到堵转值，
> 导致 **145 W 灌进 33 W 的电机**，电机瞬间烫手。
> 现在默认值是 **5 V**。

---

## 四、调试过程中发现并修复的 4 个关键问题

### 问题 1（★ 电机不转的直接原因）：`setPhaseVoltage` 写错定时器

```c
/* 原代码（错误） */
TIM_SetCompare1(TIM2, Ta*PWM_Period);   // PWM 在 TIM1，写 TIM2 等于没写
```

PWM 输出改到 TIM1(PA8/9/10) 后，这个函数还在写 TIM2 —— FOC 算出的占空比
全部写进一个没接输出的定时器，**PA8/9/10 上永远只有 0**。

**修复**：改为 `TIM_SetCompare1(TIM1, ...)`（`SimpleFOC/BLDCMotor.c`）

### 问题 2：`SystemInit()` 不配置 PLL

原工程实际跑 **HSI 8 MHz** 而非 72 MHz：
- PWM 频率从 25 kHz 变成 **2.8 kHz**
- I2C 时序假设全错

**修复**：显式配置 PLL 到 72 MHz（HSE 8MHz × 9），失败退回 HSI 64 MHz。

### 问题 3：I2C 读超时后总线卡死

`I2C_getRawCount()` 所有超时路径直接 `return 0`，**不产生 STOP**，
主机把 SCL 拉死 → 之后每次读都失败 → `angle` 恒为 0。

**修复**：加 `I2C_ReadAbort()`，超时时产生 STOP、清 POS 位、恢复 ACK；
两处无超时的死等也补上保护。

### 问题 4：电流采样零点在 EN 使能前后漂移

CSA 在 EN 拉高后才工作，输出基线整体抬高约 **290 counts（0.78 A）**。

**修复**：零点必须在 **EN 使能之后**标定（上电时序：EN → 延时 300ms → 标定零点）。

---

## 五、两套固件

### 固件 A：`mini_test.c`（★ 已验证可用，安全性最高）

- **完全不依赖 SimpleFOC 库**，只用 SPL，逻辑简单到可以逐行检查
- 六步换相，不用编码器
- 内置电流采样 + **过流硬切断**（超阈值立即 EN 拉低）
- **已实测：成功转动，空载电流 < 0.1 A**

**命令**：

| 命令 | 作用 |
|---|---|
| `?` | 状态（EN/保护/电压/电流/CCR） |
| `E` / `D` | 使能 / 失能（急停） |
| `V<x>` | 电压上限（V） |
| `L<x>` | 过流阈值（A） |
| `C0` / `C1` | 过流保护 关 / 开 |
| `S<x>` | 每步毫秒数（默认 20，越大越慢） |
| `R` | 开始旋转（带保护，自动停） |
| `Z` | 零电流测试（锁定转子，逐步加压测电流） |
| `I` | 读电流 |
| `K` | 重新标定电流零点 |
| `J<x>` | 电流标定系数 |

**安全测试流程**：

```
V2      限压 2V（约 0.3A）
L1.5    过流 1.5A
C1      打开保护
S60     每步 60ms（慢）
R       旋转
```

### 固件 B：`user/main.c`（正式固件，带闭环）

在参考工程基础上做了安全性重构：
- 时钟配置到 72 MHz
- 参数集中在文件头部，注释写明依据
- **上电默认失能**，分阶段启动（失能 → 使能 → 对齐）
- 启动时打印完整安全参数供核对
- `D` 命令急停、`V/G/L` 在线调参并带范围钳制与警告
- ⚠️ **闭环（编码器对齐）尚未验证通过**，需要先确认 AS5600 通信稳定

---

## 六、安全操作规程

### 上电前
1. 万用表量电机两相之间电阻，确认约 **6.5 Ω**（不是 0，也不是无穷大）
2. 确认驱动板电源、蓝板电源、GND 都接对
3. 确认 `voltage_limit` ≤ 5 V（首次测试）

### 首次测试
1. **先不接电机**，量 PA8/PA9/PA10 有 25 kHz PWM
2. 按「固件 A 安全测试流程」从 2 V 起
3. **手放在电源开关上**，盯着电流表

### 判据（出现任一立即断电）
| 现象 | 含义 |
|---|---|
| 电流 > 1.5 A | 超额，可能在失步或堵转 |
| 电机烫手 | 立即停，等冷却 |
| 异响/抖动 | 换相不对或失步 |
| 电流突然飙升 | 立即断电 |

### 危险操作（绝对避免）
- ❌ `voltage_limit` 超过 10 V
- ❌ 开环旋转时把每步毫秒数设得太小（磁场太快 → 失步 → 堵转 → 大电流）
- ❌ 电机未固定就上电
- ❌ 电机烫手时继续通电

---

## 七、145 W 事故复盘

**当时的配置**：`voltage_limit = 12 V` + 开环每步 5 ms

**发生的事**：
1. 12 V 对应约 1.85 A（132% 额定），本身已超额
2. 开环磁场转太快，转子跟不上 → **失步**
3. 失步后等效于**堵转**，电流按 `24V / 6.5Ω ≈ 3.7 A` 走
4. `24 V × ~6 A ≈ 145 W` 灌进 **33 W 的电机**

**教训**：
- 开环控制**必须**从极低速开始，逐步加速
- 电流保护**必须**有（软件 + 电源限流双保险）
- 任何参数调整后，第一次测试都要用最低电压

---

## 八、仍然待办

| 项目 | 说明 |
|---|---|
| **编码器稳定性** | AS5600 之前偶发读失败（返回 0 → angle 变 NaN）。已加 I2C 超时清理，需重测确认 |
| **闭环对齐** | 需要编码器稳定后才能跑通 `alignSensor()` |
| **正式固件编译** | `user/main.c` 已改好，需在 Keil 里 Rebuild 烧录 |
| **电流标定系数** | 现按 0.3 V/A 假设，可用固件 A 的 `J` 命令配合外部电流表精调 |
| **双电机** | 硬件上只需再复制一套 PWM/EN/CS 引脚 |
