SkyHao723/new_gimbal/keil5_foc/User/motor_config.h

#ifndef MOTOR_CONFIG_H
#define MOTOR_CONFIG_H

/* Same motor, phase wiring and magnet mounting as foc_official/src/main.cpp. */
#define MOTOR_POLE_PAIRS          11
#define MOTOR_SENSOR_DIRECTION    1
#define MOTOR_ZERO_ELECTRIC       0.92f
#define MOTOR_SUPPLY_VOLTAGE      24.0f
#define MOTOR_VOLTAGE_LIMIT       3.0f
#define MOTOR_MAX_VOLTAGE         5.0f
#define MOTOR_VELOCITY_LIMIT      20.0f
/* Retuned for the measured ring/stick-slip near pi: stronger proportional
   damping/stiffness, slower integral, less velocity-feedback delay. */
#define MOTOR_VELOCITY_P          0.6f
#define MOTOR_VELOCITY_I          2.0f
#define MOTOR_VOLTAGE_RAMP        1000.0f
#define MOTOR_VELOCITY_FILTER_TF  0.02f
#define MOTOR_ANGLE_P             30.0f
#define MOTOR_TARGET_SLEW         4.0f
#define MOTOR_TARGET_ACCEL        4.0f  /* rad/s^2; 0 -> 4 rad/s in 1s */

/* Set to 0 to boot disabled without moving. No alignment sweep is performed. */
#define STARTUP_ROTATE_ONCE       1
#define STARTUP_ROTATE_VELOCITY   4.0f
#define STARTUP_ROTATE_TOLERANCE  0.03f
#define STARTUP_ROTATE_TIMEOUT_MS 10000u
#define MOTOR_PWM_HZ             25000u
#define ENCODER_I2C_HZ           100000u

#endif
