SkyHao723/new_gimbal/keil5_host/User/main.c

/* Host board (G431 CAN master) bring-up firmware
 *
 * Goal: verify the four peripherals on a fresh board with no external code:
 *   1) clock + console UART (CH343P)   2) LED PA5
 *   3) GPIO I2C + ICM-42670-P (IMU)    4) FDCAN1 + the three driver boards
 *   5) USART2 towards ESP32-S3 (init only, protocol deferred)
 *
 * Console commands (115200 8N1):
 *   h / ?     help
 *   i         rescan I2C bus
 *   m         read IMU once
 *   n         poll the three driver boards (broadcast '?' and collect 2 s)
 *   c<N> <cmd>  send command to driver node N:  c1 T0.5   c2 M1   c0 V2.5 (c0 = broadcast)
 *   b         board status (clock, CAN error counters)
 *   l         toggle LED
 *
 * NOTE: kept ASCII-only because Keil ARMCC5 rejects UTF-8 multibyte literals.
 */

#include "stm32g4xx_hal.h"
#include "clock.h"
#include "console.h"
#include "esp_link.h"
#include "host_board.h"
#include "host_config.h"
#include "can_host.h"
#include "icm42670.h"
#include <stdio.h>
#include <string.h>

static ImuInfo imu;
static uint32_t cmd_from_usb;
static uint32_t cmd_from_esp;

/* ---- Load board (the old host board at the far end of the bus) -----------
 * It streams its own IMU over CAN:
 *   0x2A0  [0]=seq [1..2]=ax [3..4]=ay [5..6]=az  (int16 LE, mg) [7]=imu_ok
 *   0x2A1  [0]=seq [1..2]=gx [3..4]=gy [5..6]=gz  (int16 LE, 0.1 dps) [7]=temp C
 *   0x2A2  [0..1]=rate_hz [2]=telemetry_on [3]=imu_ok [4..7]=samples
 */
#define LOAD_CAN_ID_ACC     0x2A0u
#define LOAD_CAN_ID_GYRO    0x2A1u
#define LOAD_CAN_ID_STATUS  0x2A2u

typedef struct {
    uint8_t  valid;
    uint8_t  seq;
    uint8_t  imu_ok;
    int16_t  acc_mg[3];
    int16_t  gyro_tenth_dps[3];
    int8_t   temp_c;
    uint16_t rate_hz;
    uint8_t  telemetry_on;
    uint32_t samples;
    uint32_t frames;
    uint32_t last_ms;
} LoadState;

static LoadState load;

static int16_t load_get_i16(const uint8_t *src)
{
    return (int16_t)((uint16_t)src[0] | ((uint16_t)src[1] << 8));
}

/* Returns 1 when the frame belonged to the load board (and was consumed). */
static int load_handle_frame(const CanFrame *f)
{
    uint32_t now = HAL_GetTick();

    switch (f->id) {
    case LOAD_CAN_ID_ACC:
        if (f->dlc < 8u) {
            return 1;
        }
        load.seq = f->data[0];
        load.acc_mg[0] = load_get_i16(&f->data[1]);
        load.acc_mg[1] = load_get_i16(&f->data[3]);
        load.acc_mg[2] = load_get_i16(&f->data[5]);
        load.imu_ok = f->data[7];
        load.valid = 1u;
        load.last_ms = now;
        ++load.frames;
        return 1;
    case LOAD_CAN_ID_GYRO:
        if (f->dlc < 8u) {
            return 1;
        }
        load.gyro_tenth_dps[0] = load_get_i16(&f->data[1]);
        load.gyro_tenth_dps[1] = load_get_i16(&f->data[3]);
        load.gyro_tenth_dps[2] = load_get_i16(&f->data[5]);
        load.temp_c = (int8_t)f->data[7];
        return 1;
    case LOAD_CAN_ID_STATUS:
        if (f->dlc < 8u) {
            return 1;
        }
        load.rate_hz = (uint16_t)((uint16_t)f->data[0] | ((uint16_t)f->data[1] << 8));
        load.telemetry_on = f->data[2];
        load.samples = (uint32_t)f->data[4] | ((uint32_t)f->data[5] << 8)
                     | ((uint32_t)f->data[6] << 16) | ((uint32_t)f->data[7] << 24);
        return 1;
    default:
        return 0;
    }
}

static void report_load(void)
{
    uint32_t age;

    if (!load.valid) {
        printf("[LOAD] no telemetry yet - check load board 5V, CANH/CANL wiring, board power\r\n");
        return;
    }
    age = HAL_GetTick() - load.last_ms;
    printf("[LOAD] seq=%u age=%lums frames=%lu samples=%lu rate=%uHz on=%u imu=%u\r\n",
           (unsigned)load.seq, (unsigned long)age, (unsigned long)load.frames,
           (unsigned long)load.samples, (unsigned)load.rate_hz,
           (unsigned)load.telemetry_on, (unsigned)load.imu_ok);
    printf("[LOAD] acc[g] %.3f %.3f %.3f  gyro[dps] %.1f %.1f %.1f  temp=%d C\r\n",
           (double)load.acc_mg[0] / 1000.0, (double)load.acc_mg[1] / 1000.0,
           (double)load.acc_mg[2] / 1000.0,
           (double)load.gyro_tenth_dps[0] / 10.0, (double)load.gyro_tenth_dps[1] / 10.0,
           (double)load.gyro_tenth_dps[2] / 10.0, (int)load.temp_c);
}

static void print_banner(void)
{
    printf("\r\n===== G431 host board bring-up =====\r\n");
    printf("SYSCLK=%lu Hz  HCLK=%lu  PCLK1=%lu  PCLK2=%lu\r\n",
           (unsigned long)HAL_RCC_GetSysClockFreq(), (unsigned long)HAL_RCC_GetHCLKFreq(),
           (unsigned long)HAL_RCC_GetPCLK1Freq(), (unsigned long)HAL_RCC_GetPCLK2Freq());
    printf("UART1 PA9/PA10 <-> CH343P @ %lu 8N1   (command input A)\r\n", (unsigned long)HOST_CONSOLE_BAUD);
    printf("UART2 PA2/PA3  <-> ESP32-S3 @ %lu 8N1   (command input B)\r\n", (unsigned long)HOST_ESP_BAUD);
    printf("GPIO-I2C PB6/PB7 -> ICM-42670-P   FDCAN1 PB8/PB9 @ 500k   LED PA5\r\n");
    printf("Type h for the command list\r\n");
}

static void report_imu(void)
{
    int16_t acc[3], gyr[3], temp = 0;
    if (!imu_read_raw(&imu, acc, gyr, &temp)) {
        printf("IMU: read failed (%s)\r\n", imu_last_error());
        return;
    }
    printf("IMU acc[g] %.3f %.3f %.3f   gyro[dps] %.1f %.1f %.1f   temp %.1f C\r\n",
           acc[0] / 2048.0f, acc[1] / 2048.0f, acc[2] / 2048.0f,
           gyr[0] / 16.4f, gyr[1] / 16.4f, gyr[2] / 16.4f,
           25.0f + temp / 128.0f);
}

static void imu_bringup(void)
{
    uint8_t found[16];
    int n;

    /* 先初始化 PB6/PB7 软件 I2C，否则后面的扫描/读寄存器全是空转 */
    imu_i2c_init();

    /* 先做引脚级总线自检（结果存 RAM，串口打不开也能用 SWD 读 bus_diag[8]），
       内部会顺带做 9 个时钟的总线解锁并恢复 GPIO I2C */
    imu_bus_diag();

#if HOST_I2C_PIN_DRIVE_TEST
    printf("[I2C] PIN DRIVE TEST: PB6/PB7 push-pull, 5 s low / 5 s high (measure IMU side)\r\n");
    imu_i2c_pin_drive_test();          /* never returns */
#endif

    printf("\r\n[I2C] scanning 0x08..0x77 ...\r\n");
    printf("[I2C] bus levels  pu=%02lX pd=%02lX clear=%02lX\r\n",
           (unsigned long)bus_diag[0], (unsigned long)bus_diag[1], (unsigned long)bus_diag[3]);
    printf("[I2C] GPIO scan PB6=SCL PB7=SDA: %lu device(s), first 0x%02lX; swapped: %lu, first 0x%02lX\r\n",
           (unsigned long)sw_scan[0], (unsigned long)sw_scan[1],
           (unsigned long)sw_scan[2], (unsigned long)sw_scan[3]);
    n = imu_scan(found, 16);
    imu_bus_diag_scan_result(n, found);
    if (n <= 0) {
        printf("[I2C] no device found - check PB6/PB7 pull-ups, IMU 3V3, AP_CS high, AP_AD0 address\r\n");
        return;
    }
    printf("[I2C] %d address(es):", n);
    for (int i = 0; i < n && i < 16; ++i) printf(" 0x%02X", found[i]);
    printf("\r\n");
    if (!imu_init(&imu)) {
        printf("[IMU] init failed: %s\r\n", imu_last_error());
        return;
    }
    printf("[IMU] OK  addr=0x%02X  WHO_AM_I=0x%02X  I2C = GPIO bit-bang %lu kHz\r\n",
           imu.address, imu.who_am_i,
           (unsigned long)(500u / IMU_I2C_HALF_PERIOD_US));
    report_imu();
}

/* Broadcast '?' and print whatever the driver boards answer.
   Each driver streams its printf output as a run of 8-byte CAN frames, and the
   three boards reply at the same time, so the frames interleave. Keep one line
   buffer per node and print a whole line when it is complete ('\n') or the node
   has been quiet for 40 ms. */
#define CAN_LINE_SLOTS 8u
static char can_line[CAN_LINE_SLOTS][200];
static unsigned can_line_len[CAN_LINE_SLOTS];
static uint32_t can_line_ms[CAN_LINE_SLOTS];

static unsigned can_slot_of(uint32_t id)
{
    if (id >= 0x281u && id <= 0x287u) return id - 0x280u;
    return (id == 0u) ? 0u : (CAN_LINE_SLOTS - 1u);
}

static void can_flush_slot(unsigned slot)
{
    if (can_line_len[slot] == 0u) return;
    can_line[slot][can_line_len[slot]] = 0;
    printf("[N%u] %s\r\n", slot, can_line[slot]);
    can_line_len[slot] = 0u;
}

static void can_flush_idle(uint32_t now)
{
    unsigned i;
    for (i = 1u; i < CAN_LINE_SLOTS; i++) {
        if (can_line_len[i] != 0u && (now - can_line_ms[i]) > 40u) can_flush_slot(i);
    }
}

static void can_append_frame(const CanFrame *f, uint32_t now)
{
    unsigned slot = can_slot_of(f->id);
    unsigned k;
    for (k = 0u; k < f->dlc; k++) {
        char ch = (char)f->data[k];
        if (ch == '\r') continue;
        if (ch == '\n') { can_flush_slot(slot); continue; }
        if (can_line_len[slot] >= sizeof(can_line[0]) - 1u) can_flush_slot(slot);
        can_line[slot][can_line_len[slot]++] = ch;
    }
    can_line_ms[slot] = now;
}

/* Drain the receive ring and print complete lines. Called from the main loop, so
   replies to 'c<N> <cmd>' show up without blocking. */
static void can_poll_replies(void)
{
    CanFrame f;
    uint32_t now = HAL_GetTick();
    while (can_host_recv(&f)) {
        if (!load_handle_frame(&f)) {
            can_append_frame(&f, now);
        }
    }
    can_flush_idle(now);
}

static void can_scan_drivers(void)
{
    uint32_t t0;
    int printed = 0;
    unsigned i;

    for (i = 0u; i < CAN_LINE_SLOTS; i++) { can_line_len[i] = 0u; can_line_ms[i] = 0u; }

    if (!can_host_send_command(0u, "?")) {
        printf("[CAN] send failed (bus not ready)\r\n");
        return;
    }
    printf("\r\n[CAN] broadcast '?', collecting replies for 2 s (PSR=0x%08lX ECR=0x%08lX)\r\n",
           (unsigned long)can_host_psr(), (unsigned long)can_host_error_count());

    t0 = HAL_GetTick();
    for (;;) {
        uint32_t now = HAL_GetTick();
        can_host_service();
        can_poll_replies();
        if ((now - t0) > 2000u) break;
    }
    for (i = 1u; i < CAN_LINE_SLOTS; i++) {
        if (can_line_len[i] != 0u) { can_flush_slot(i); ++printed; }
    }
    (void)printed;
}

static void can_bringup(void)
{
    printf("\r\n[CAN] init FDCAN1 500k ... ");
    if (!can_host_init()) {
        printf("FAILED (check PB8/PB9 and TJA1042 supply)\r\n");
        return;
    }
    printf("OK  PSR=0x%08lX\r\n", (unsigned long)can_host_psr());
    can_scan_drivers();
}

/* 't' 命令: IMU 连续读压力测试, 用 DWT 计时, 报成功率与单次耗时 */
static void imu_stress(void)
{
    int16_t acc[3], gyr[3], temp = 0;
    int i, ok = 0;
    uint32_t t0, t1, cycles;
    (void)imu_read_raw(&imu, acc, gyr, &temp);        /* warm up once */
    t0 = DWT->CYCCNT;
    for (i = 0; i < 200; ++i) {
        if (imu_read_raw(&imu, acc, gyr, &temp)) ok++;
    }
    t1 = DWT->CYCCNT;
    cycles = t1 - t0;
    printf("[STRESS] %d/200 OK, total %lu us, %.0f us/read, %.1f Hz max\r\n",
           ok, (unsigned long)(cycles / (HAL_RCC_GetHCLKFreq() / 1000000u)),
           cycles / (HAL_RCC_GetHCLKFreq() / 1000000u) / 200.0f,
           200.0f * (float)HAL_RCC_GetHCLKFreq() / (float)cycles);
}
/* 'e': ESP32 link self-test. Half-duplex mode connects TX back into RX inside
   the UART, so the whole path (TX -> line -> RX interrupt -> ring -> line
   assembly) can be verified without the ESP32 being programmed yet. Replies are
   routed to USB during the test so the echoed text cannot loop forever. */
static void esp_link_selftest(void)
{
    char buf[32];
    int saved_route, got = 0;
    uint32_t t0;

    uint32_t pins[4];

    printf("ESP link: UART2 PA2=TX PA3=RX @ %lu 8N1  ready=%d rx=%lu bad=%lu/%lu ignored=%lu dropped=%lu\r\n",
           (unsigned long)HOST_ESP_BAUD, esp_link_ready(),
           (unsigned long)esp_link_rx_bytes(),
           (unsigned long)esp_link_bad_lines(), (unsigned long)esp_link_bad_bytes(),
           (unsigned long)esp_link_ignored_lines(), (unsigned long)esp_link_dropped_bytes());

    { char smp[96]; esp_link_sample(smp, sizeof(smp)); printf("[ESP-SAMPLE] framing_err=%lu ""%s""\r\n", (unsigned long)esp_link_rx_errors(), smp); }
    esp_link_pin_test(pins);
    printf("[ESP-PINS] idle PA2=%lu PA3=%lu | PA2 low -> PA3=%lu | PA2 high -> PA3=%lu\r\n",
           (unsigned long)pins[0], (unsigned long)pins[1],
           (unsigned long)pins[2], (unsigned long)pins[3]);
    if (pins[2] == 0u && pins[3] == 1u)
        printf("[ESP-PINS] PA3 follows PA2 -> TX and RX are wired together (check ESP32 side)\r\n");
    else if (pins[1] == 0u)
        printf("[ESP-PINS] PA3 idles low -> external driver pulling it down / ESP32 TX stuck\r\n");
    else
        printf("[ESP-PINS] PA3 idles high and does not follow PA2 -> wiring looks sane\r\n");

    saved_route = console_route();
    console_set_route(CONSOLE_OUT_USB);
    USART2->CR3 |= USART_CR3_HDSEL;              /* internal TX -> RX loopback */
    esp_link_flush_input();
    esp_link_puts("hw\r\n");
    t0 = HAL_GetTick();
    while ((HAL_GetTick() - t0) < 50u) {
        if (esp_link_read_line(buf, sizeof(buf))) { got = 1; break; }
    }
    USART2->CR3 &= ~USART_CR3_HDSEL;
    esp_link_flush_input();
    console_set_route(saved_route);

    if (got && !strcmp(buf, "hw")) printf("[ESP-LINK] loopback OK (UART2 path works)\r\n");
    else printf("[ESP-LINK] loopback FAIL (got '%s')\r\n", got ? buf : "");
}
static void print_status(void)
{
    printf("SYSCLK=%lu  CAN PSR=0x%08lX ECR=0x%08lX rx=%lu busoff=%lu txdrop=%lu\r\n",
           (unsigned long)HAL_RCC_GetSysClockFreq(), (unsigned long)can_host_psr(),
           (unsigned long)can_host_error_count(), (unsigned long)can_host_rx_count(),
           (unsigned long)can_host_bus_off_count(), (unsigned long)can_host_tx_dropped());
    printf("UART1 dropped=%lu  UART2(ESP) dropped=%lu rx=%lu bad=%lu/%lu  IMU addr=0x%02X\r\n",
           (unsigned long)console_dropped_bytes(), (unsigned long)esp_link_dropped_bytes(),
           (unsigned long)esp_link_rx_bytes(), (unsigned long)esp_link_bad_lines(),
           (unsigned long)esp_link_bad_bytes(), imu.address ? imu.address : 0u);
    printf("commands: USB=%lu  ESP=%lu  reply route=%d (1=USB 2=ESP 3=both)\r\n",
           (unsigned long)cmd_from_usb, (unsigned long)cmd_from_esp, console_route());
    printf("ESP input: only lines starting with '@' are executed (e.g. @m, @c1 T0.5); muted=%d muted_drops=%lu\r\n",
           esp_link_muted(), (unsigned long)esp_link_muted_drops());
}

static void handle_command_body(char *line)
{
    if (!strcmp(line, "h") || !strcmp(line, "?")) {
        printf("\r\n=== upper-board console (UART1 / CH343P USB) ===\r\n");
        printf("  h / ?        this help\r\n");
        printf("  b            board status: clock, CAN, UART counters, IMU\r\n");
        printf("  m            read the IMU once\r\n");
        printf("  t            IMU stress test (200 reads, timing)\r\n");
        printf("  i            I2C scan + re-init the IMU\r\n");
        printf("  n            poll the driver boards on CAN\r\n");
        printf("  k            load board (old host board) IMU telemetry\r\n");
        printf("  l            toggle the LED\r\n");
        printf("  e            ESP32 (UART2) link self-test\r\n");
        printf("  c<N> <cmd>   forward a command to driver board N (0 = broadcast)\r\n");
        printf("                 c1 T0.5   c1 M1   c1 ?   c0 V2.5\r\n");
        printf("line editing: ENTER send, BACKSPACE delete, Ctrl-U clear line, Ctrl-C cancel\r\n");
        printf("commands are accepted on UART1 (USB) and UART2 (ESP32); the reply goes back to the source\r\n");
        return;
    }
    if (!strcmp(line, "i")) { imu_bringup(); return; }
    if (!strcmp(line, "m")) { report_imu(); return; }
    if (!strcmp(line, "t")) { imu_stress(); return; }
    if (!strcmp(line, "e")) { esp_link_selftest(); return; }
    if (!strcmp(line, "n")) { can_scan_drivers(); return; }
    if (!strcmp(line, "k")) { report_load(); return; }
    if (!strcmp(line, "b")) { print_status(); return; }
    if (!strcmp(line, "l")) { host_led_toggle(); printf("LED toggled\r\n"); return; }
    if (line[0] == 'c' && line[1] >= '0' && line[1] <= '7' && line[2] == ' ') {
        uint8_t node = (uint8_t)(line[1] - '0');
        if (can_host_send_command(node, &line[3])) printf("TX node%u -> '%s'\r\n", node, &line[3]);
        else printf("bad command (E/D/?/R/H = 1 byte; T/V/L/M need a value)\r\n");
        return;
    }
    printf("unknown command, type h\r\n");
}

/* Executes one command line. `from_esp` selects where the reply goes so that
   the two links never see each other's traffic (they are not used together). */
static void handle_command(char *line, int from_esp)
{
    if (from_esp) ++cmd_from_esp; else ++cmd_from_usb;
    console_set_route(from_esp ? CONSOLE_OUT_ESP : CONSOLE_OUT_USB);
    handle_command_body(line);
    console_set_route(CONSOLE_OUT_BOTH);
}

int main(void)
{
    char line[96];
    uint32_t next_blink, next_service;
    int guard;

    if (!clock_init()) {
        for (;;) { }                       /* clock failed: stay here for the debugger */
    }
    console_init(HOST_CONSOLE_BAUD);
    host_board_init();
    host_led(1);
    print_banner();

    esp_link_init(HOST_ESP_BAUD);
    printf("[UART2] PA2/PA3 command input ready @ %lu (second input, ESP32 bridging deferred)\r\n",
           (unsigned long)HOST_ESP_BAUD);

    imu_bringup();
    can_bringup();
    printf("\r\nReady. Type h for help.\r\n");
    console_prompt();

    next_blink = HAL_GetTick() + 500u;
    next_service = HAL_GetTick();
    for (;;) {
        uint32_t now = HAL_GetTick();
        if (console_read_line(line, sizeof(line))) {
            handle_command(line, 0);
            console_prompt();
        }
        guard = esp_link_guard(HAL_GetTick());
        if (guard == 2) {
            int saved = console_route();
            console_set_route(CONSOLE_OUT_USB);
            printf("[ESP-LINK] noisy input (>3 kB/s) - ESP input muted for 5 s; check PA2/PA3 wiring\r\n");
            console_set_route(saved);
        }
        if (!guard && esp_link_read_line(line, sizeof(line))) handle_command(line, 1);
        if (now >= next_service) { can_host_service(); next_service = now + 20u; }
        can_poll_replies();
        if (now >= next_blink) {
            host_led_toggle();
            next_blink = now + 500u;
        }
    }
}
