SkyHao723/new_gimbal/keil5_host/BSP/icm42670.h

#ifndef HOST_ICM42670_H
#define HOST_ICM42670_H

#include <stdint.h>
#include "host_config.h"

/* PB6/PB7 在 STM32G431 上没有 I2C1 复用功能（PB6=UCPD1_CC1/TIM4/TIM8/TIM16/USART1），
   所以只能用 GPIO 开漏 bit-bang。半位延时 2us => SCL 250 kHz。 */
#define IMU_I2C_HALF_PERIOD_US   2u

/* ICM-42670-P（六轴 IMU）走 PB6=SCL / PB7=SDA 软件 I2C，开漏；
   STM32G431 的 PB6 不支持 I2C1_SCL 复用。
   寄存器按 bank0 直接读，没做 FIFO / 中断，够点板和后续姿态解算用。 */

typedef struct {
    uint8_t address;        /* 0x68 或 0x69 */
    uint8_t who_am_i;
    uint8_t speed_code;     /* GPIO bit-bang, 0=10 kHz */
} ImuInfo;

/* 初始化 PB6/PB7 开漏 GPIO I2C。返回 1 成功，0 失败（信息见 imu_last_error()）。 */
int imu_i2c_init(void);

/* 扫描 0x08..0x77，把有应答的地址写进 found[]，返回个数（最多 max）。 */
int imu_scan(uint8_t *found, int max);

/* 探测一块 IMU：核对 WHO_AM_I(0x75)==0x67，成功后配置电源模式。
   返回 1 成功；0 没找到 / 型号不符。 */
int imu_init(ImuInfo *imu);

/* 读一次原始数据：加速度（LSB/g = 2048）与角速度（LSB/dps = 16.4）。
   返回 1 成功。 */
int imu_read_raw(const ImuInfo *imu, int16_t accel[3], int16_t gyro[3], int16_t *temp_raw);

const char *imu_last_error(void);

/* Bring-up bus diagnostics. Results stay in RAM so they can be read over SWD
 * even when the USB serial port is unavailable.
 *   bus_diag[0] : IDR snapshot, internal PULL-UP   (bit6=SCL, bit7=SDA, 1=high)
 *   bus_diag[1] : IDR snapshot, internal PULL-DOWN (1 => external pull-up fitted)
 *   bus_diag[2] : number of SCL clocks issued by the bus-clear routine (9)
 *   bus_diag[3] : IDR snapshot after bus-clear (pull-up again)
 *   bus_diag[4] : address scan hit count
 *   bus_diag[5] : first hit address | (second hit << 8)
 *   bus_diag[6] : GPIOB->MODER after I2C GPIO setup
 *   bus_diag[7] : PWR->CR3 (UCPD dead-battery pull-down must be disabled)
 */
extern volatile uint32_t bus_diag[8];
/* Software-I2C scan (bypasses the peripheral, tests wiring/address/power):
 *   sw_scan[0] hits with SCL=PB6/SDA=PB7, sw_scan[1] first address found
 *   sw_scan[2] hits with SCL=PB7/SDA=PB6, sw_scan[3] first address found      */
extern volatile uint32_t sw_scan[4];
void imu_bus_diag(void);
void imu_bus_diag_scan_result(int found_count, const uint8_t *found);
#if HOST_I2C_PIN_DRIVE_TEST
void imu_i2c_pin_drive_test(void);
#endif

#endif
