SkyHao723/new_gimbal/keil5_g431/BSP/as5600.h

#ifndef AS5600_H
#define AS5600_H
#include <stdint.h>

typedef struct {
    float mechanical;
    float angle;
    float velocity;
    int32_t turns;
    uint32_t timestamp;
    uint32_t errors;
    uint8_t valid;
} Encoder;

void as5600_init(void);
int as5600_update(Encoder *sensor);
/* Milliseconds since the raw angle last changed; 0 while no change was seen
   yet.  Used to catch the sensor dropping into its 100 ms polling mode. */
uint32_t as5600_ms_since_change(void);
#endif
