SkyHao723/new_gimbal/(commit log)

2026-10-15 初始提交：STM32F103 云台电机测试工程
    硬件: STM32F103C8T6 + SimpleFOC Mini(DRV8316C) + AS5600
    已验证功能:
    - TIM1 三路 PWM (PA8/PA9/PA10), 25kHz 中心对齐
    - 六步换相旋转, 空载电流 < 0.1A
    - ADC 电流采样 (CS1/CS2/CS3 -> PA0/PA1/PB1) + 零点自动标定
    - 过流硬切断保护 (超阈值立即拉低 EN)
    - 72MHz 时钟配置 (HSE x9, 失败退回 HSI 64MHz)
    目录:
    - app/ 测试版主程序 mini_test.c
    - build/ 构建脚本 + GCC 启动文件/链接脚本
    - library/ STM32F10x 标准外设库
    - reference/ 参考工程 (SimpleFOC 移植版, 用于将来移植 G431)
    - docs/ 接线表 + 调试总结与安全指南
    安全提示:
    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
2026-10-15 构建修复：补齐 stm32f10x_conf.h 与头文件搜索路径
    - 新增 app/stm32f10x_conf.h（SPL 配置头）
    - build_mini.ps1 头文件路径增加 app/ 目录
    - 验证：干净构建产物与实测通过的固件 SHA256 完全一致
2026-10-15 新增闭环 FOC 实施规划
    阻塞点分析: 编码器在控制循环中读取不可靠
    - 慢速调试时能读, 控制主循环中长期运行出现 I2C 读失败 -> 返回 0 -> shaftAngle 变 NaN
    - 对齐必然失败 -> sensor_direction 恒为 0 -> 所有闭环模式失效
    - 危害: 脏数据导致换相角错误 -> 失步 -> 等效堵转 -> 大电流
    阶段划分(6 阶段, 每个都有验收标准与停止条件):
    0. 基线与安全网 (可回退固件)
    1. 编码器可靠性攻坚 <-- 关键门, 错误率 < 0.1%
    2. 引入 FOC 库并安全共存 (空转 30min 不卡死)
    3. 对齐 <-- 关键门, sensor_direction != 0
    4. 闭环三模式验证 (力矩 -> 速度 -> 位置)
    5. 电流保护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
2026-10-15 阶段1通过: 编码器可靠性验证 (错误率 0.0000%)
    新增健壮版 AS5600 驱动 app/encoder.c/.h:
    - 每个等待点有限超时, 超时必发 STOP 释放总线 (原驱动的致命缺陷)
    - 失败返回明确错误码, 绝不返回 0 冒充有效角度
    - 双读一致性校验 + 跳变丢弃 + 统计(abort/recover/outlier)
    - 总线恢复: SCL 打脉冲解救卡死的从机
    新增独立测试固件 app/encoder_test.c (不输出 PWM, EN 保持失能):
    - M 磁铁状态 / L 线路电平 / J<n> 抖动 / T<n> 压力测试 / C 长跑
    - K<Hz> 在线改 I2C 速率 / D<hex> 读任意寄存器
    实测结果:
    - 静止抖动 1 LSB (要求 <5)
    - 20000 次压力测试: 0/40000 失败, 错误率 0.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
2026-10-15 阶段2: FOC 库安全集成空转框架 + 编码器加速版(A/B待验证)
    隔离式集成设计 (关键):
    - app/MyProject.h 精简版: 去掉 iic.h/spi2.h, 库不再直接操作 I2C
    - 库的 getAngle()/getVelocity() 桥接到阶段1验证过的 app/encoder.c
    - 新增 app/SimpleFOC/* (库源码原样) + app/Hardware/(timer.c, delay.c)
    阶段2固件 app/foc_idle_test.c (电机不转, 仅验证集成稳定性):
    - EN 保持失能, PWM 强制为 0, 目标恒 0
    - 独立看门狗 IWDG 4s 兜底
    - 持续 NaN 检测 + 循环速率统计
    发现并规避的严重隐患:
    FOCMotor.c 中 voltage 是【全局未初始化变量】, 而 loopFOC() 会无条件执行
    setPhaseVoltage(voltage.q, voltage.d, .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
2026-10-15 阶段3: 编码器与标定打通; 闭环受阻于起动死点
    ## 已验证可用
    - 编码器 AS5600: 40000 次读零失败, 手动转轴 raw 316->3885 正常跟踪
    - 编码器标定: 反复一致 (mech≈-0.64, offset≈-4.49), 绝对编码器无需传统对齐
    - 六步换相开环能让电机转: 角度 -2.19->-1.47, 电流稳定 0.15A
    - 电流采样小电流段准确: 0.5V->0.049A, 1.0V->0.138A, 1.5V->0.224A
    - 过流保护多次正确动作
    - TIM1 PWM / 72MHz 时钟 正常
    ## 受阻: 闭环无法起转
    现象: 闭环下给电压转子不动, 编码器恒定, 电角度为常数
    根因【起动死点】: 标定把转子锁在 elec=0, 力矩 T∝sin(0)=0
    闭环换相角来自编码器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
2026-10-15 阶段3续: 找到官方参考代码, 修正零点标定角度, 确认闭环通路已通
    ## 找到官方参考(关键)
    常用测试源码-配合说明书使用/ESP32_SimpleFOC_BLE/.pio/libdeps/.../Simple FOC/
    - 官方最新版 SimpleFOC 完整库(之前用的是 2019 年老版移植)
    - FOCMotor.cpp: 官方 initFOC/alignSensor 实现
    - BLDCMotor.cpp: 官方 setPhaseVoltage SVPWM
    - examples/hardware_specific_examples/SimpleFOCMini/angle_control/
    ★ SimpleFOCMini 驱动板专用例程(与我们的板子完全对应)
    ## 官方黄金参数(云台电机)
    PID_velocity.P=0.2 I=20 D=0 <- 积分占主导, 我用的 I=1.0 弱 20 倍
    voltage_sensor_align=3V, voltage_limit=6V, output_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
2026-10-15 电流采样外部标定: 加入直流标定法 + 平均值采样
    ## 从用户实测数据得到的关键事实
    电机两相电阻实测 3.8 ohm (万用表, 三相都是 3.8)
    功率计(总电源位置)实测:
    2V -> 0.049A 3V -> 0.0845A 5V -> 0.2015A
    反推有效电阻 37~60 ohm, 远大于万用表的 3.8 ohm
    ## 发现的核心问题: ADC 异步于 PWM 导致采样错位
    现象: PWM 开着时固件读数在 0.005A 和 0.3A 之间剧烈跳动,
    而功率计稳定在 0.084A
    根因: ADC 自由连续转换(~200kHz), 与 25kHz PWM 不同步,
    平均值要么全落在'导通期'要么全落在'关断期'
    (32 次采样只覆盖 0.16ms, 而 PWM 周期 0.04ms)
    影响: 这解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
2026-10-15 重要更正: 电流采样准确(电流表证实); 电机真实电阻仅 0.6~1.3 ohm
    ## 更正之前的错误结论
    用户用独立电流表实测: B2 测试固件读数 1.62A, 电流表 1.6A -> 完全吻合
    => A_per_cnt = 0.00269 A/count 是正确的, 电流采样链路没问题
    => 我之前'增益偏大3倍应改为0.00084'的推断是错的(用功率计间接推算导致)
    => 之前认为'5.46A尖峰是虚假读数'也是错的, 那很可能是真实冲击电流
    ## 教训
    标定电流必须用独立可靠的仪表(电流表串在回路里),
    不要用总电源功率计间接推算, 更不要用'理论电阻x欧姆定律'反推,
    因为电机电阻随接线方式测量结果差异巨大。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
2026-10-15 最终更正: 电机未损伤(两台电机都测 3.8/4.4 ohm); 安全电压 4V
    ## 电机健康: 未损伤
    全新未拆封同款: 3.8 ohm
    被烫过的电机: 4.4 ohm (+16%)
    判断: 绕组过热短路会让电阻变小, 不会变大。现在略大 => 没有匝间短路
    最可能是漆包线轻微退火, 电机可用。
    ## 重要更正: 万用表 3.8 ohm 是可信的
    之前我怀疑'万用表偏大因为驱动板并联' -> 这个怀疑是错的。
    用两台独立电机测出同一个值 3.8 ohm。
    ## 过热事故的最终解释
    真实电阻 3.8 ohm, B2 施加 2V -> 真实电流应为 2/3.8 = 0.53A
    固件显示 1.62A -> 多出的 1.1A 来自【零点漂移】
    证据: 电机【关闭】时固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
2026-10-15 安全架构: 七层保护, 根治反复烧电机问题
    ## 为什么会反复烧: 唯一的保护层本身不可靠
    旧保护代码每 10ms 才检查一次电流(=250个PWM周期), 且完全依赖
    有零点漂移的电流读数。用一个不可靠的传感器驱动唯一的保护动作。
    ## 七层保护(任一层失效其余仍能阻止烧毁)
    1. 极低起步电压 1.0V (约0.26A, 之前用3~5V)
    2. 唯一出口硬限幅 —— 关键设计: 所有电压输出都经过 set_phase_voltage(),
    限幅写在函数入口, 任何代码路径都绕不过。请求12V实际只出2V。
    这一层【不依赖电流读数】
    3. 过流阈值 0.8A = 额定1.4A的57%
    4. 每步检查(1ms, 之前10ms)
    5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
2026-10-15 方案A成功: PlatformIO + 官方 SimpleFOC 库跑通闭环对齐
    ## 决定改用官方库
    厂家 Keil 工程用的是 2019 年的 SimpleFOC 移植版, 而工作区里藏着
    官方最新版完整库(在 ESP32 项目的 PlatformIO 依赖里):
    常用测试源码-配合说明书使用/ESP32_SimpleFOC_BLE/.../Simple FOC/
    官方库原生支持 STM32F1, 且自带蓝板专用示例:
    examples/hardware_specific_examples/Bluepill_examples/
    magnetic_sensor/bluepill_position_control/ <- AS5600 闭环
    我们前面踩的坑(PWM定时器/ADC同步采样/对齐零点/看门狗)官方都已处理好。
    ## 新工程 foc_official/
    - platformio.ini STM32F103C8 + Arduino + SimpleFOC 2.4.0
    -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
2026-10-15 Web 控制器适配官方固件: 移除开环/编码器诊断面板
    ## 命令集变更
    官方 SimpleFOC 固件只支持: E D T<n> V<n> L<n> R ?
    旧固件的 H/S/P/O/N/G/A/Y/Z/Q/W 全部不存在了, 所以重写控制器。
    ## 已移除
    - 开环诊断面板 (相位测试 W / 进入开环 O / 退出开环 N / 对齐电压 G)
    - 编码器诊断面板 (探测 A / 原始值 R / I2C速率 Y / 失败计数 Z / FOC状态 Q)
    原因: 官方库自带 initFOC() 对齐, 位置环能正常工作即说明编码器与
    换相都正确, 不需要这些排查工具。
    ## 新界面
    - 设备连接: COM 口 + 波特率(115200)
    - 实时状态: EN/角度/速度/目标/限压/母线电压/传感器方向/电角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
2026-10-15 修复串口丢包与对齐失败; 闭环小步跟踪已验证; 新增交接文档
    ## 修复1: 串口命令丢包 (已验证解决)
    根因: Arduino STM32 core 的串口命名与直觉不同
    cores/arduino/Serial.cpp:
    Uart Serial1(USART1); <- Serial1 是 USART1 (PA9/PA10)
    Uart Serial2(USART2); <- Serial2 才是 USART2 (PA2/PA3)
    PA9/PA10 已被 PWM 占用, 用 Serial1 等于操作一个引脚被抢走的串口
    -> 命令丢一半
    修复: platformio.ini 加 HAVE_HWSERIAL2 + PIN_SERIAL2_TX/RX,
    main.cpp 改用核心的 Serial2 (删掉手写的 MyUart)
    实测: 20x R -> 20/20, 20x ? -> 20/20, 突发10条 -> 10/10
    参数命令真的生效 (V2.5 -> Vlim=2.50, T1.234 -> tgt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
2026-10-15 更新交接文档: 串口与对齐问题已修复验证
    交接说明.md:
    - 顶部加提示: 本文是调试过程完整记录, 最新状态见 docs/调试成果-2026-10-15.md
    - 第七节: 7.1(串口) 7.2(对齐) 标记为已修复并附实测证据
    7.3 改为'闭环大幅移动失稳'作为当前主要待解决项, 附调参方向
    - 第九节: 更新已验证/待解决清单, 更新当前固件启动日志
    - 第十一节: 一句话总结改为反映修复后的真实状态
2026-10-16 保存 Keil5 静音稳定固件基线及配套控制工具
    保留 11 极对、固定零点、上电机械单圈自检、目标斜坡及串口修复。用户确认无噪音且静止不抖；运动顿挫作为下一轮独立优化。
2026-10-16 平滑位置轨迹并抑制到位摆动，保存实机验证记录
2026-10-27 保存 G431 移植前的 F103 提速/收敛工作与测量记录
2026-10-27 G431: 三路相电流采样与限幅接入, 闭环打通(pp=11/dir=-1/zero=1.697), 电压上限 2.5-8V 扫描
2026-10-27 G431: CAN 打通并实测连续运动/阶跃/限流折叠与跳闸
2026-10-27 web 控制器接 G431: 新增 CAN<->WebSocket 桥, 浏览器可直接驱动; 正常停机不再误报 FAULT
2026-10-27 G431: 抖动诊断基建(抓波形/FFT/自动扫参) + 软件I2C可调到5us + 速度估计窗口开关
    - bench_current: 新增 bench_capture_run() 把控制循环(角度/速度/uq)抓进 RAM，SWD 读回后 FFT
    - as5600: 软件 I2C 半周期改为 ENCODER_I2C_HALF_US 宏(默认 25us)，实测 5us 下循环 460Hz -> 1.9kHz 且无 I2C 错误
    - encoder_tracking: 增加 ENCODER_VELOCITY_WINDOW 多周期差分(默认 1=F103 原行为)，F103 不定义该宏
    - tools: g431_can_jitter.py / g431_jitter_analyze.py / g431_jitter_compare.py
    - 主循环: 正常失能拉低 nSLEEP 不再误报 FAULT nFAULT low
    - 结论: 增益扫描(Ap12/Vp1.2/Vi4)一度把 3-50Hz 抖动从 6.6 压到 4.0 mrad，但之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
2026-10-27 退回 3c2d4eb 的 G431 固件版本(保留抖动诊断工具脚本)
    用户反馈 e70dd86 的固件版本比上一版更差，固件源码按要求整体回退到上个版本；
    tools/ 下新增的抖动诊断脚本保留，供后续量化使用。
2026-10-27 G431 抖动根因: AS5600 掉进 100ms 低功耗轮询 (PMOD=LPM3) 导致 10Hz 反馈与 10Hz 极限环; 上电复位 PMOD=00 + 周期重写 + 编码器停滞看门狗; 实测抖动 74.5mrad -> 8.8mrad
2026-10-27 tools: 新增 g431_jitter_probe.py 抖动量化工具 (cruise/step)
2026-10-27 G431: 抬高转速上限 MOTOR_TARGET_SLEW 6->20 rad/s, 实测 18 rad/s 平稳/18.7 受 1.6A 折叠限制
2026-10-27 修复 README 被误清空(81cc4a5); 补转速上限实测数据; web 页面电压上限放宽到 8V 并写明三层限流
2026-10-27 CAN: 每板节点号 BOARD_CAN_NODE(命令0x200+n/回复0x280+n)+广播0x200; 双滤波器; 工具 --node; build_nodes.ps1 一次生成三个hex; README 多板接线检查
2026-10-27 G431: 按 CAN 节点分别配置零点与方向(calib.h); 板3 实测 pp=11/dir=+1/zero=0.566
2026-10-28 G431: 板2 按实测重标定(dir=-1/zero=0.274); 修复编码器停滞看门狗误跳闸; 抖动探针支持 --node
2026-10-28 G431 板2: 双向拉轴零点标定(dir=-1/zero=0.122), 标定使能重试, 拟合工具 g431_fit_align.py 与三块板标定文档
2026-10-28 G431 板3: 双向拉轴重标 zero=0.487(dir=+1), 验收 0.011deg/8.3-12.9mrad, 补 AS5600 卡总线排障说明
2026-10-28 G431 板1: 双向拉轴重标 zero=1.227(单次拉轴偏 27 度), 验收实测, 三块板同总线联调通过
2026-10-28 文档: 三块板选项字节均已确认, 修正残留的待办条目
2026-10-28 web 控制器支持多节点: CAN 桥 --nodes 1,2,3 + 页面节点选择/三块板总览; 桥改用 JSON 帧 {node,cmd}/{node,text}
2026-10-28 G431: 修复 CAN 广播 0x200 被丢的问题(只认本节点ID); 三块板广播 E/T/V/D 生效
2026-10-28 文档+页面: 澄清 I pk 是单相电流峰值(母线电流约其 1/5~1/10, 实测 3V 锁相 0.79A 对应电源 0.09A)
2026-10-28 G431: 位置环增益 40->25 消除 ~57Hz 极限环(保持抖动), 加入 X 黑匣子抓波形
2026-10-28 文档: 三块板同益增益 25 复测结果 + 阶跃精度/互扰数据
2026-10-28 G431: 运动模式 M0(缓动/轨迹规划) 与 M1(直驱/无缓启缓停), 网页加模式按钮
2026-10-28 G431: 修正 R 命令坐标系(dir=-1 的板与 ? 反号), 补 M0/M1 实测数据
2026-10-28 G431: 板3改线序后重标零点(dir=-1/zero=1.458), 文档同步
2026-10-28 G431 上位机板: 点板固件(USART1/灯/硬件I2C+ICM42670/CAN主机) + Keil 工程 + README + 点板核对脚本
2026-10-29 上位机板: 修 SysTick_Handler 缺失(打印到一半死机) + 选项字节让芯片忽略 BOOT0; I2C 扫描提速; README 记录两坑
2026-10-29 上位机板: 修 imu_i2c_init 从未被调用(I2C1 根本没初始化, 扫描必然空)
2026-10-30 host: 加总线自检(引脚电平/软I2C双线序扫描)以便无串口时用 SWD 判读
2026-10-30 host: 加 PB6/PB7 推挽翻转测试(排查 MCU->IMU 连线)
2026-10-30 host: 恢复正常固件(关掉推挽翻转测试)
2026-10-30 docs: 存 ICM-42670-P 俯视引脚图(排查封装镜像用)
2026-10-30 host: 修 IMU 读不到 - PB6 在 G431 无 I2C1 复用, 改 GPIO bit-bang(250kHz); 修 ICM-42670 寄存器地址; 加 t 压力测试
2026-10-30 host board: dual command input (CH343P USB + ESP32 UART2), per-source reply routing, '@' prefix gate + noise guard, 'e' link/pin self-test
2026-10-30 host board: identify ESP line traffic (ESP32 ROM boot loop, blank app image), add line sample + framing-error diagnostics
2026-10-30 esp32_bridge: Arduino sketch bridging USB CDC <-> G431 UART2 (adds '@' prefix, !probe/!ping/!stat/!raw, link watchdog) + README
2026-10-30 esp32_bridge: install UART drivers once and never end() them (fixes ESP-IDF 'uart driver error' logs), show UART number in !stat, troubleshoot README 5.6
2026-10-30 esp32 bridge: 链路保活(5s @R 心跳)代替空闲判死, 不再丢命令; README 补 CDC 空白屏幕/保活说明
2026-10-30 gitignore: 忽略 esp32_bridge/build 编译产物
2026-10-30 上位机板串口终端: 本地回显 + 退格/Ctrl-U/Ctrl-C 行编辑 + ESC 序列丢弃 + 提示符; README 补用法
2026-10-30 上位机板 web 控制台: Web Serial 直连 CH343P 的单页控制台(状态卡片/相对移动/自动轮询) + 解析自测
2026-10-31 host: FDCAN 中断入口缺失导致整板死机(已修); CAN 回复按节点重组行; 网页兼容 [N1] 前缀
2026-10-31 docs(host): 记录 FDCAN 中断入口缺失导致整板死机的根因与修法
2026-10-31 load board: IMU->CAN telemetry (0x2A0/0x2A1/0x2A2); host k cmd + web card; CAN selftest; fix TJA1042 dead-transceiver root cause docs
